TibaudoRomain/ProjetAR/Reports/Romain/Report18.md

# **Séance 18 - 09/05/2024**
## Travail réalisé :
J'ai commencé la séance par travailler sur le code des nouveaux capteurs que sont le ph-mètre et le capteur de pression.



Ensuite, j'ai travaillé sur l'emplacement des composant sur la plaque à l'intèrieur du cylindre.



Puis, j'ai imprimé plus de supports pour les ESC.



Ensuite, pour réduire la place que prendra la caméra, j'ai aidé Anas à démonté la caméra logitech. Pour ce faire, on a du détâcher puis découper un des câbles pour ensuite le ressouder au circuit imprimé.



Enfin, j'ai fais le modèle pour la découpe laser de la plaque qui supporterra l'électronique.



## Objectifs pour les prochaines scéances :
- Terminer l'assemblage du robot
- Tester le code en situation
