TibaudoRomain/ProjetAR/Reports/Anas/séance 17.md

# **Séance 17**
## *07-05-2024* 
## Travail réalisé : 

Lors de cette séance, j'ai commencé par déballer les capteurs de température, de pression et le pH que nous avions reçus. J'ai effectué quelques soudures sur le capteur de pression. Ensuite, j'ai procédé à la disposition de toute notre électronique sur la pièce en bois qui sert de support. J'ai donc pris plusieurs mesures et fait des tracés afin d'optimiser l'espace à l'intérieur de notre tube. Ensuite, j'ai percé tous les trous qui serviront à fixer les cartes, les ECS, les shields et la batterie, puis j'ai fixé l'électronique à sa place.

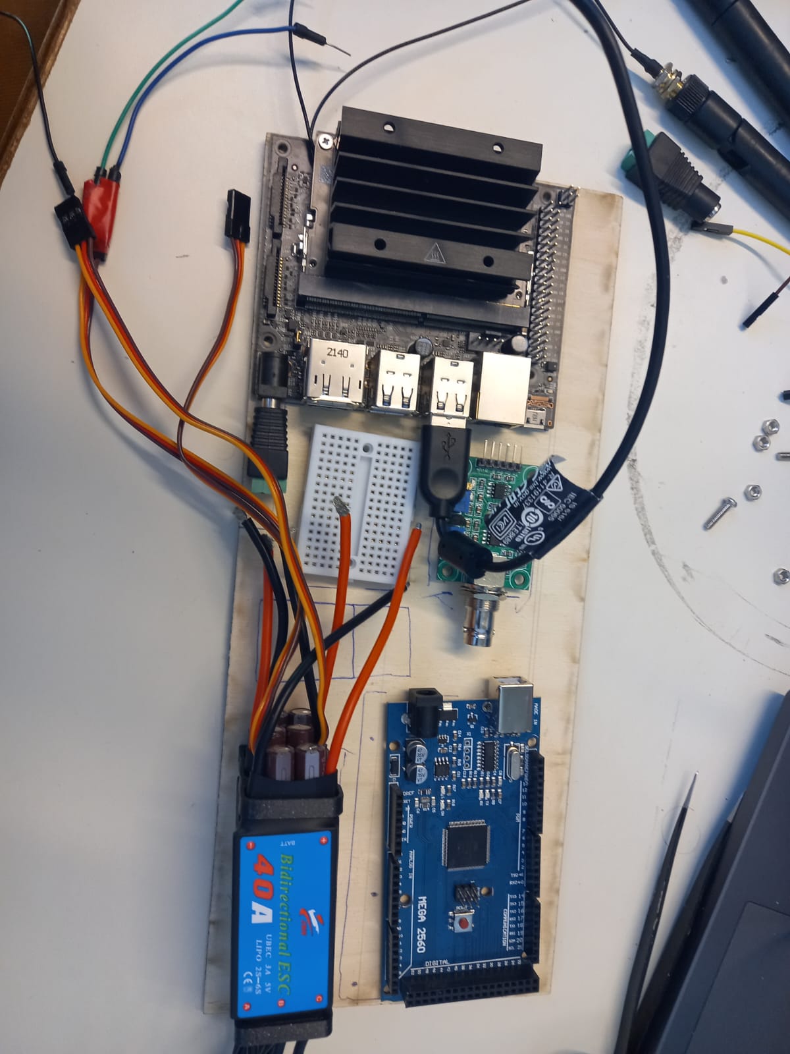
[picture p1: Reports/Anas/Images/WhatsApp Image 2024-05-08 à 16.44.29_d7d7ad65.jpg]


Ensuite, j'ai écrit un code afin de pouvoir lire les valeurs du capteur de température et du pH mètre sur la carte Jetson. J'ai trouvé une bibliothèque Python, Jetson.GPIO, qui permet de contrôler les broches GPIO de la carte Jetson. Cependant, les broches GPIO de la Jetson ne sont pas analogiques et donc ne peuvent pas traiter les données du capteur de température et du pH mètre. J'ai donc opté pour la carte Arduino pour ces capteurs-là.
