TibaudoRomain/ProjetAR/Reports/Romain/Report17.md

# **Séance 16 - 09/04/2024**
## Travail réalisé :
J'ai commencé la séance par l'assemblage du support des nouveaux moteur, pour cela j'ai vissé à la structure que j'ai préalablement percée, la plaque en plexiglass et les supports moteurs fabriqués pendant la dernière séance. Ces nouveaux supports sont bien plus solides et permettront de tenir fermement les moteurs horizontaux. Voici à quoi la structure ressemble maintenant :



Ensuite, sur les conseils de M.Peter, j'ai changé le design de la structure interne, pour créer une glissière qui permettra d'insérer les composant plus facilement tout en sauvegardant de la place. Voici les modèles 3d que j'ai modéliser pour créer cette glissière.

Les supports de la glissière :



La glissière :


Enfin, j'ai cherché un moyen de fixer les ESC au support interne, ce qui est plus compliqué que de fixer le reste des composants car il n'y a pas de points d'attache et la surface est irrégulière.



J'ai opté pour une atache par les bords des ESC, ce qui sera plus rapide que de faire un boitier. J'ai commencé par faire un prototype à la découpeuse laser qui a malheureusemant cassé.



Cependant il demeurait assez intègre pour le tester sur les ESC :



J'ai enfin modifié un peu les modèles 3d et lancé l'impression d'une partie. 



## Objectifs pour les prochaines scéances :
- Découper la plaque qui supporterra l'électronique du robot et assembler la structure interne au cylindre
