TibaudoRomain/ProjetAR/Reports/Anas/séance 15.md

# **Séance 15**
## *02-04-2024* 
## Travail réalisé : 

Lors de cette séance, j'ai rencontré plusieurs problèmes. 
Pour commencer, la carte SD de notre carte Jetson n'était plus reconnue, j'ai donc dû utiliser une autre. Pendant le temps nécessaire à l'initialisation de la carte Jetson et au téléchargement de tout le contenu, j'ai vissé les moteurs arrière au châssis, puis je les ai branchés aux ESC afin de faire une démonstration.
Je n'avais plus le temps de commencer le travail sur le modèle d'IA que nous utiliserons. Cependant, j'ai quand même cherché quel modèle pourrait nous intéresser. Ensuite, j'ai essayé d'au moins cloner le GitHub qui contient tous les modèles qui pourraient m'intéresser sur la Jetson, mais j'ai eu l'erreur suivante. 
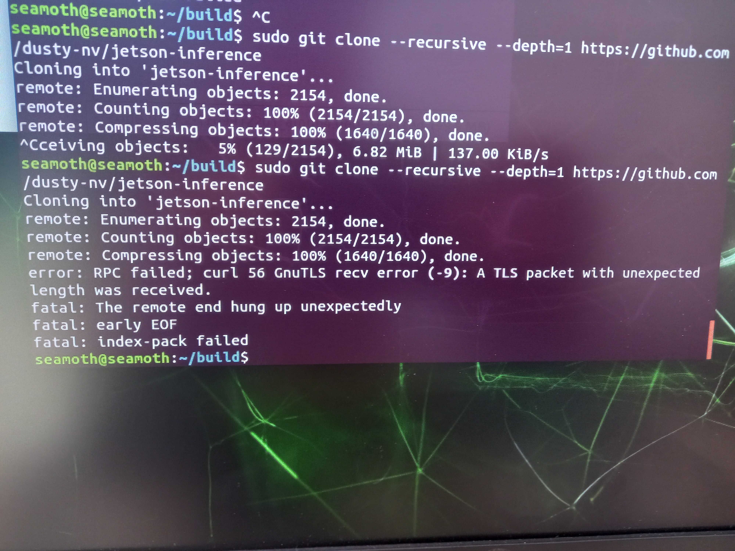
[picture p2: Reports/Anas/Images/20240402_102347.jpg]


J'ai donc passé le reste de la séance à essayer de régler ce problème.
Objectifs pour la séance prochaine : 
-       regler le probléme que j ai rencontré et avancer sur le modele d'ia
