TibaudoRomain/ProjetAR/Reports/Romain/Report16.md

# **Séance 16 - 09/04/2024**
## Travail réalisé :
J'ai commencé la séance en modifiant les modèles des supports pour les réimprimer plus rapidement.



Puis j'ai imprimé les 2 modèles.

impressionsupmot

J'ai ensuite modélisé un nouveau support plus solide pour les moteurs horizontaux et les ai imprimés.



Enfin j'ai modélisé une plaque pour attacher les supports à la structure du robot. J'ai utilisé la découpeuse laser pour créer la pièce.



## Objectifs pour les prochaines scéances :
- Créer un boitier qui permettra d'attacher les ESC et la batterie à la plaque
- Découper la plaque qui supporterra l'électronique du robot et assembler la structure interne au cylindre
