TibaudoRomain/ProjetAR/Reports/Romain/Report15.md

# **Séance 15 - 02/04/2024**
## Travail réalisé :
J'ai commencé la séance en modifiant les modèles des supports pour les rendre plus solides.



Puis j'ai imprimé la partie haute du modèle et découpé une plaque en bois pour testé l'assemblement des supports. J'ai fait cela car le temps d'impression des supports est trop long.



J'ai aussi modéliser en 3d la plaque qui servira au support des cartes, de la batterie et des ESC.



Ensuite, j'ai travaillé sur le contrôle des moteurs via bluetooth pour pouvoir présenter leur fonctionement plus facilement.

Enfin j'ai complété le programme qui servira à contrôler les moteurs avec la arduino mega.

## Objectifs pour les prochaines scéances :
- Créer un boitier qui permettra d'attacher les ESC et la batterie à la plaque
- Imprimer les supports de la plaque
- Découper la plaque et assembler la structure interne au cylindre
