TibaudoRomain/ProjetAR/Reports/Romain/Report14.md

# **Séance 14 - 19/03/2024**
## Travail réalisé :
J'ai commencé la séance en modélisant le cylindre afin de pouvoir créer plus facilement le support pour les cartes et la batterie.



Ensuite, j'ai modélisé l'attache inférieure pour le support. Cette attache va permettre au support de ne pas bouger à l'intérieur du cylindre et sera montée serrée sur le joint en bas du cylindre.




Ensuite, j'ai modélisé l'attache supérieure pour le support. Cette attache doit permettre l'ajout d'un support pour la caméra.



Cependant, pour pouvoir obtenir les mesures nécessaires afin de modéliser une attache aux bonnes dimensions, j'ai dû créer plusieurs disques avec la découpeuse laser et tester s'ils s'inséraient bien dans le joint.

J'ai enfin pu commencer à créer un programme pour contrôler les moteurs avec mon téléphone. Je n'ai besoin que de contrôler les moteurs horizontaux car les autres vont, pour l'instant, servir uniquement à la stabilisation du robot.

## Objectifs pour les prochaines scéances :
- Assembler l'électronique du robot
- Imprimer le support
- Améliorer le PID
