TibaudoRomain/ProjetAR/Reports/Anas/séance 14.md

# **Séance 14**
## *29-03-2024* 
## Travail réalisé : 

Lors de cette séance, j'ai commencé par prendre des mesures sur le tube en plexiglas afin que mon collègue puisse le modéliser sur Fusion 360.

Ensuite, je me suis mis à fixer les pièces imprimées lors de la dernière séance à notre base en bois. J'ai pris les mesures nécessaires, puis j'ai effectué les marquages pour les vis avant de les visser.
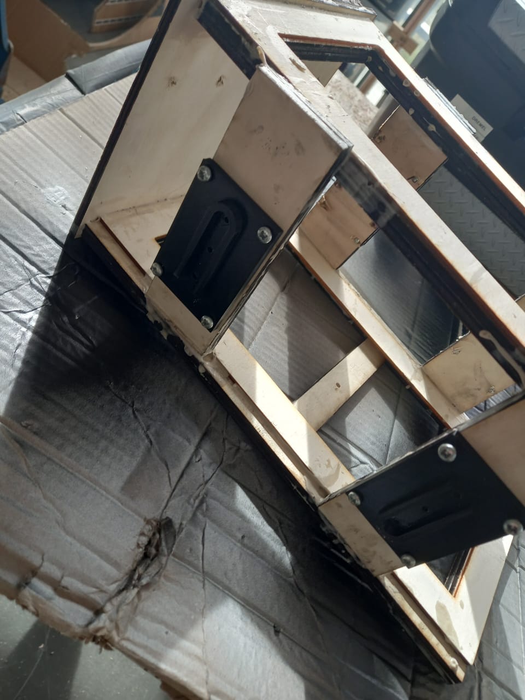
[picture p3: Reports/Anas/Images/WhatsApp Image 2024-03-30 à 11.53.24_18565550.jpg]


Ensuite, j'ai attaché les moteurs à la structure.

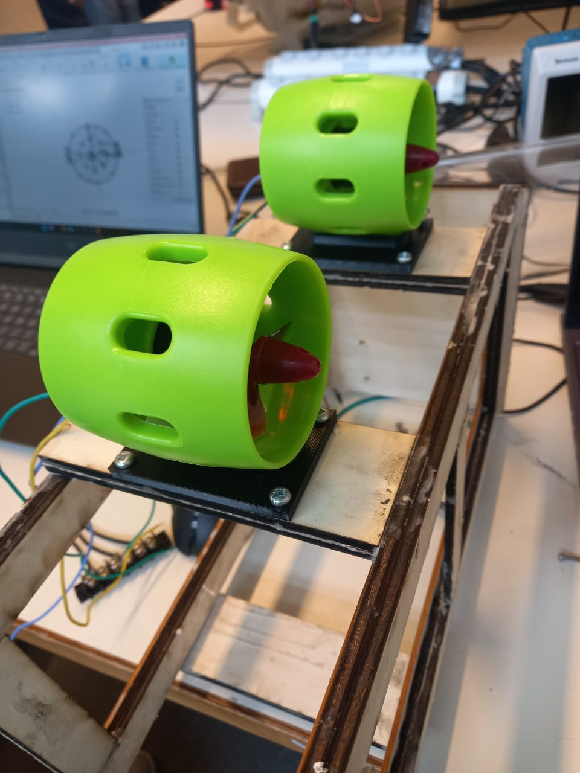
[picture p4: Reports/Anas/Images/WhatsApp Image 2024-03-30 à 11.53.24_260b4752.jpg]


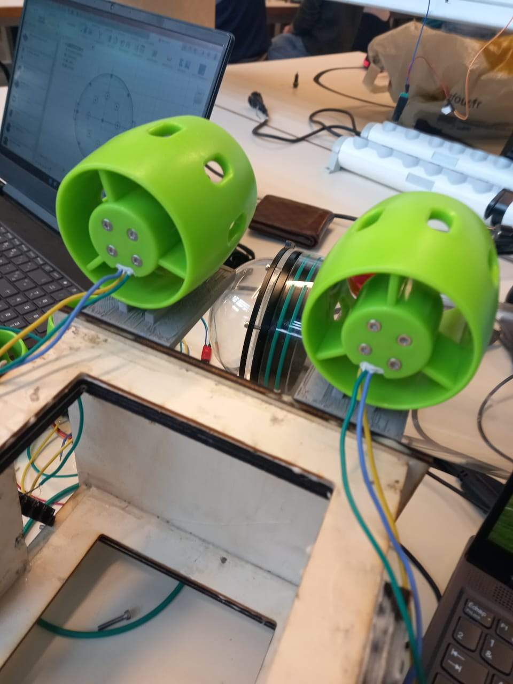
[picture p5: Reports/Anas/Images/WhatsApp Image 2024-03-30 à 11.53.24_44018f7d.jpg]


Enfin, je me suis mis à la recherche d'un modèle d'IA qui nous permettrait de naviguer sous l'eau à l'aide de notre caméra. J'ai trouvé plusieurs modèles de NVIDIA très intéressants pour notre projet.



Objectifs pour la séance prochaine : 
- Essayer les modèles trouvés sur la Jetson Nano afin de déterminer leur utilité pour notre projet.
