TibaudoRomain/ProjetAR/Reports/Romain/Report12.md

# **Séance 11 - 06/03/2024**
## Travail réalisé :
J'ai commencé la séance en imprimant en 3d des pièces manquantes pour la structure du robot. 



Ensuite, j'ai testé le sonnar sous l'eau en remplissant une boite d'eau.



Cependant malgrés le fait que la distance soit supèrieur à 20cm les mesures étaient inconssistantes, en effet peu importe à quel point j'écartais le sonnar de l'obstacle la distance restait à environ 80cm. J'ai ensuite regardé la datasheet qui m'a indiqué que le sonnar est prévu pour fonctionner sur une portée de 20 à 600cm. 



Or le son se déplace 4 fois plus vite dans l'eau que dans l'air donc une distance de 80cm serait logique.
J'ai ensuite essayé de tester le capteur pour une distance plus longue. 



Cependant du à l'angle de mesure de 75° le bassin utilisé était trop fin ce qui m'a empéché de faire des mesures. J'ai ensuite retenté en modifiant le programme ce qui m'a rendu la même chose. Ensuite j'ai aidé mon coéquipier à assembler une partie de la structure.

## Objectifs pour les prochaines scéances :
- Régler le problème de mesure à courtes distances du sonnar
- Faire un programme permettant au robot de se déplacer
- Programmer l'évitement d'obstacles
