TibaudoRomain/ProjetAR/Reports/Romain/Report11.md

# **Séance 11 - 06/03/2024**
## Travail réalisé :
J'ai commencé la séance en travaillant sur le sonar. Celui-ci me donnant des valeurs pas stables et peu précises, ce qui peut empiéter sur le déplacement du robot et lui faire détecter des obstacles qui n'existent pas. Le premier problème que j'ai voulu régler est la stabilité de la mesure en effet quand j'essaie de faire des mesures avec le sonar je me retrouve avec des suites de valeurs contenant des valeurs isolées qui différencient fortement du reste.



Pour régler ce problème, j'ai décidé de prendre plus de mesures (avec une fréquence plus grande) de les séparer en groupe de 11 mesures puis de renvoyer la médiane de ces mesures. Pour ce faire, j'ai choisi d'ajouter les 11 premières valeurs dans une liste à 11 éléments puis d'ordonner la liste en utilisant un tri par insertion et de renvoyer le 6e élément de la liste, de même pour les 11 prochaines valeurs et ainsi de suite. Cependant, après avoir recherché comment le tri fonctionnait, je n'ai pas réussi à l'implémenter, la liste initialisée comme une liste de 11 zéros n'acceptait pas les valeurs par lesquels j'essaiyais de changer les zéros.

Cependant, pour ne pas perdre de temps, je me suis mis à régler l'autre problème du sonar, les distances qu'il renvoie ne sont pas assez précise, à une distance de 1m le sonar renvoyait une distance de 93.5 cm. 



J'ai donc mesuré la différence de distance entre la réalité et ce que mon programme renvoyait pour pouvoir trouvé un facteur par lequel je peux multiplier la valeur du sonar pour avoir des mesures plus précises.





J'ai aussi pu remarquer un autre problème, pour des distances en dessous de 28 cm le sonar ne me renvoie que des valeurs autour de 25 cm, même si la distance est de 5 cm.

## Objectifs pour les prochaines scéances :
- Régler le problème de mesure à courtes distances du sonnar
- Faire un programme permettant au robot de se déplacer
- Programmer l'évitement d'obstacles
