TibaudoRomain/ProjetAR/Reports/Anas/séance 6.md

# **Séance 6**
## *16-01-2024* 

## Travail réalisé :

Lors de cette séance de projet, j ai finalisé la modelisation de notre coque exterieur.
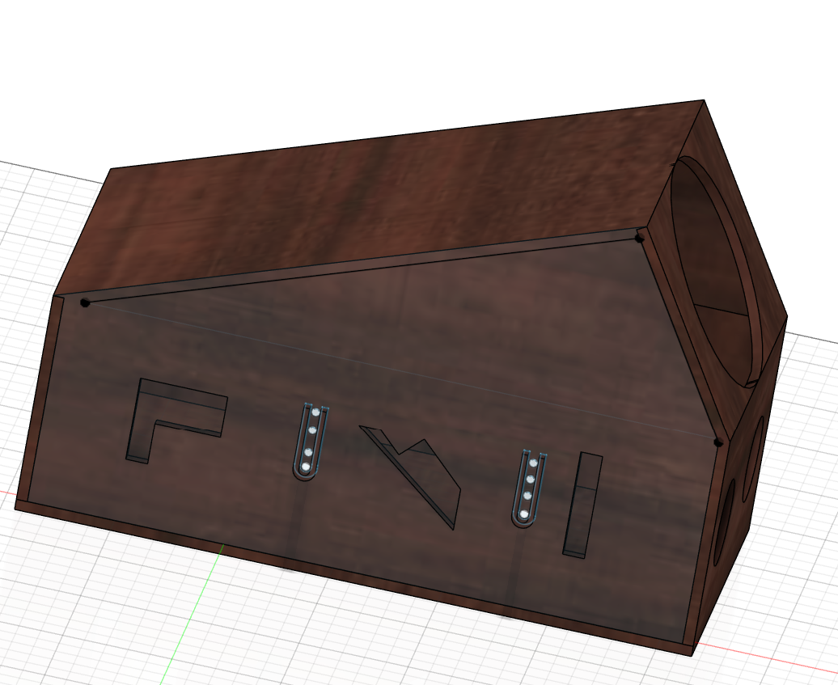
[picture p6: Reports/Anas/Images/coque V3.png]

Maintenant que la conception est terminée, je me suis lancé dans l'impression de toutes les pièces de fixation que j'avais modifiées. Lors de l'impression du attache-tube, j'ai rencontré un problème de conception. J'ai donc changé ma façon de voir les choses et ai décidé de simplement tarauder la pièce de fixation après l'avoir imprimée.
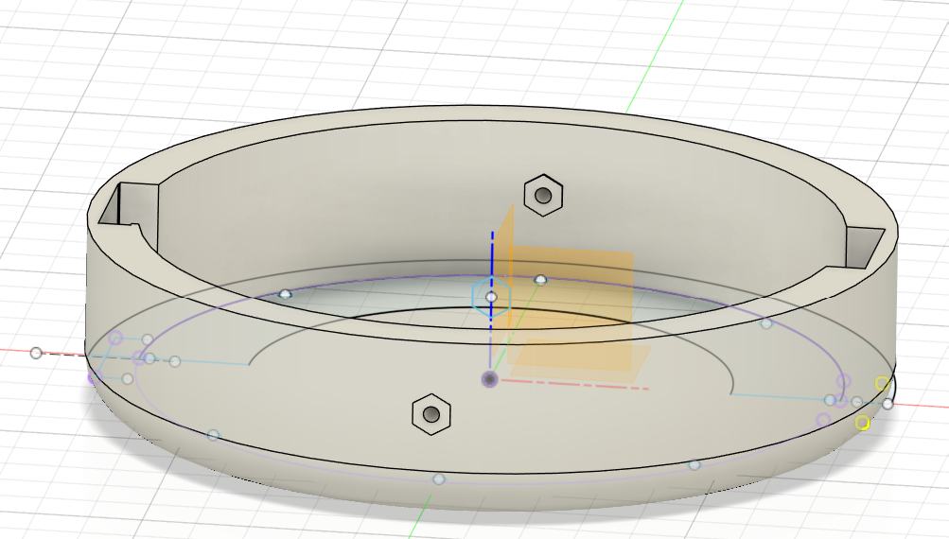
[picture p7: Reports/Anas/Images/attache tube.png]

Ensuite, j'ai réfléchi à une manière de partitionner notre tube afin de pouvoir fixer nos composants électroniques de manière efficace, sans encombrement. J'ai donc modélisé une pièce qui servira à organiser l'intérieur de notre tube
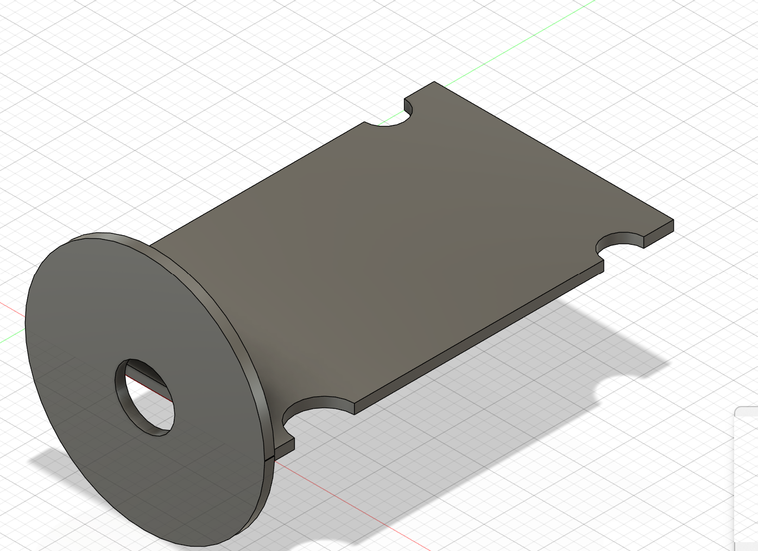
[picture p8: Reports/Anas/Images/fixation electronique.png]


Objectif de la séance prochaine : 
-	Modéliser une solution de fixation pour les deux moteurs à l'arrière de la boîte, puis construire notre robot.
