TibaudoRomain/ProjetAR/Reports/Anas/séance 5.md

# **Séance 3**
## *08-12-2023* 

## Travail réalisé :
Lors de cette séance de projet, j'ai concentré mes efforts sur la sélection d'un modèle de coque pour notre projet. Après une analyse minutieuse, j'ai fait le choix d'un modèle qui répond le mieux à nos critères .j'ai aussi opté pour le bois comme matériau pour la coque, vu la simplicité de travailler avec du bois, et surtout parce que nos critères d'étanchéité ne concernent pas cette pièce-là.
Ensuite, j'ai entamé la modélisation 3D de cette coque ,en prenant en compte les spécifications et les détails techniques nécessaires. Loin d'une simple enveloppe pour notre projet, j'ai choisi un modèle qui incarne l'innovation et la créativité, un modèle géométrique simpliste mais efficace.
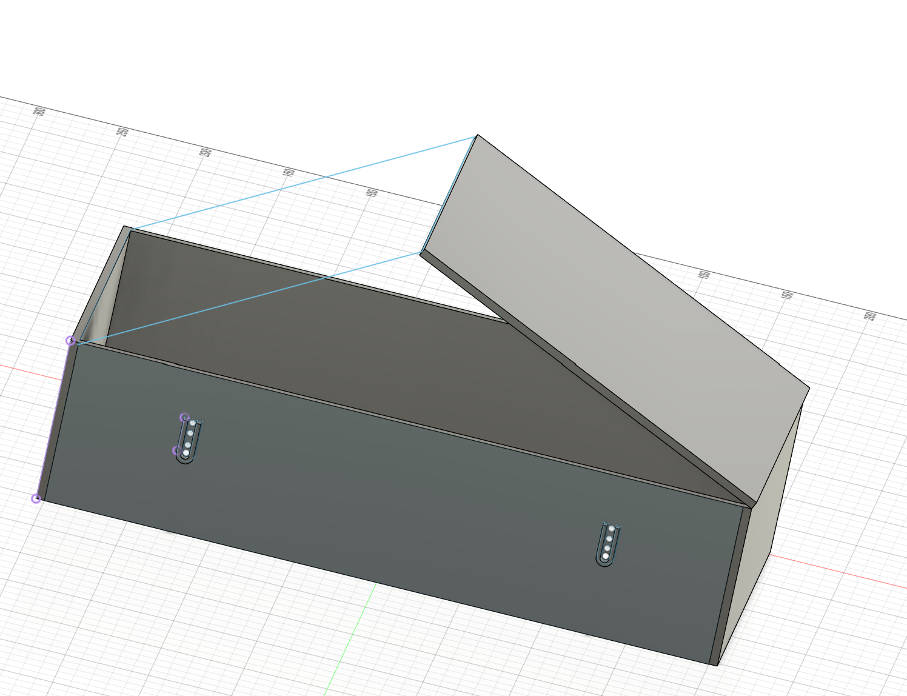
[picture p9: Reports/Anas/Images/coque V1.png]

J'ai également modélisé une pièce permettant de fixer les moteurs aux faces de la coque, lesquels seront ensuite vissés. Cependant, en raison d'une erreur concernant le tube commandé, j'ai dû revoir toutes les solutions de fixation pour le tube. Désormais, je prévois d'intégrer une fixation directement dans la coque ainsi qu'une trappe à l'arrière de celle-ci, permettant un accès au tube sans démontage. Cette trappe sera percée pour faciliter le passage des fils nécessaires de l'intérieur du tube vers l'extérieur, en utilisant la méthode que Xavier nous a montrée lors de la dernière séance.

Objectif de la séance prochaine : 
-	construire la coque et imprimer toutes les pièces de fixation avant de passer au montage final.
