TibaudoRomain/ProjetAR/Reports/Romain/Report04.md

# **Séance 4 - 12/12/2023**
## Travail réalisé :
Après avoir écrit l'image de la jetson nano sur la carte SD, je me suis penché sur la centrale inertielle MPU 6050 :


J'ai commencé par faire les branchements et souder connecteurs à la centrale inertielle.



Ensuite j'ai testé le programme exemple de l'IDE pour la MPU 6050 nommé MPU6050DMP6 en ayant installé au préalable les librairies MPU6050 et I2Cdev. Cependant le programme me renvoi le message d'erreur suivant :



N'ayant pas trouvé la solution, j'ai testé d'autres programme dont celui ci-dessous qui m'a renvoyer trois angles nuls qui ne changeaient pas peu importe comment je déplaçais la centrale inertielle.



## Objectifs pour la semaine prochaine :
Pour la prochaine scéance, l'objectif sera de faire marcher une centrale inertielle et de commencé à coder des communications entre l'arduino et la jetson.
