TibaudoRomain/ProjetAR/Reports/Anas/séance 2.md

# **Séance 2**
## *21-11-2023* 
## Travail réalisé :
Pendant cette séance, je me suis intéressé aux différentes solutions possibles pour rendre étanche la boîte où  notre partie électrique sera stocké. L'impression 3D est une solution réalisable, mais cela pose plusieurs défis qui sont certes surmontables. Cependant, nous recherchons ici la simplicité. 
Ainsi, un tube en plexiglas représente la solution optimale. Ce tube d'un diamètre de 110 mm et d'une hauteur de 30 cm, avec deux bouchons à joint fixés par des vis. Cette solution nous permet d'assurer une étanchéité optimale tout en nous permettant d'intervenir à l'intérieur de la boîte sans causer de fuites.


En ce qui concerne les câbles, nous prévoyons de les relier tous ensemble et de les envelopper dans un tube flexible pour les joindre à l'un des couvercles de notre boîte. J'ai donc recherché le matériel dont nous avons besoin afin de passer commande le plus rapidement possible. Ensuite, j'ai modélisé une solution pour fixer notre tube à la coque de notre robot extérieur.



Ces fixations serviront à bloquer le tube dans la coque afin de ne pas endommager tout ce qui se trouve à l'intérieur du tube.

La modélisation de toutes les pièces de fixation est presque terminée. Il ne me reste plus qu'à attendre de recevoir le tube afin de prendre les mesures de dernière minute et d'imprimer toutes les fixations.

Objectifs pour la séance prochaine : 
-       imprimer les fixations
-       avancer sur le modele de la coque exterieur
