TibaudoRomain/ProjetAR/Présentation/PresentationSeamoth.pdf

# Projet Seamoth

Par Malhouq Anas et Tibaudo Romain

# Présentation du projet

Objectifs :
- Se déplacer sous l’eau de manière autonome
- Analyser son environnement

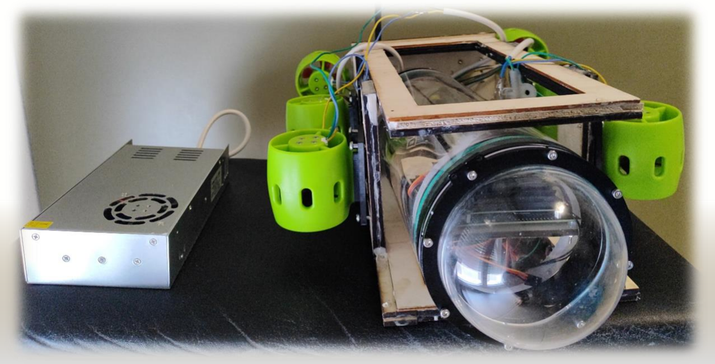
[picture p17: figure]

# Fonctionnement général

- Synoptique

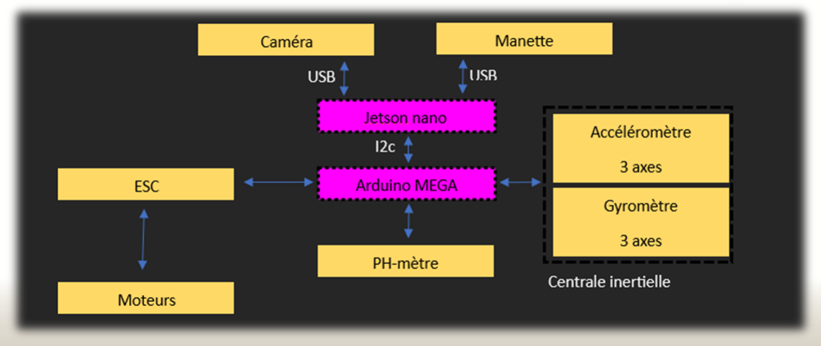
[picture p18: figure]

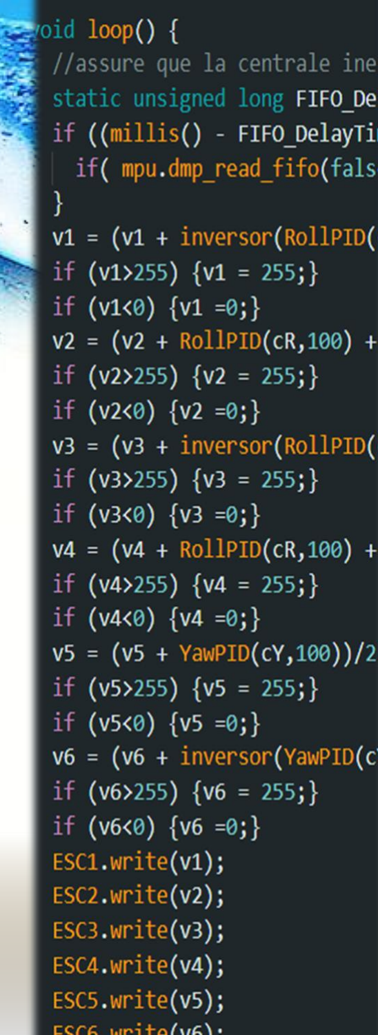
[picture p19: figure]

# Fonctionnement du code

- Une Arduino MEGA pour le déplacement
- Une Centrale inertielle
- Un PID pour la stabilisation
- 6 ESC pour contrôler les moteurs
- Une Jetson Nano pour analyser son environnement
- Une caméra
- Un modèle d’IA pour faire un recensement des espèces
- Une manette pour contrôler la direction des moteurs
- Un code master sur la Jetson pour lire les inputs de la manette.
- Un code slave sur l’Arduino pour recevoir les données via i2c

# L’architecture du robot

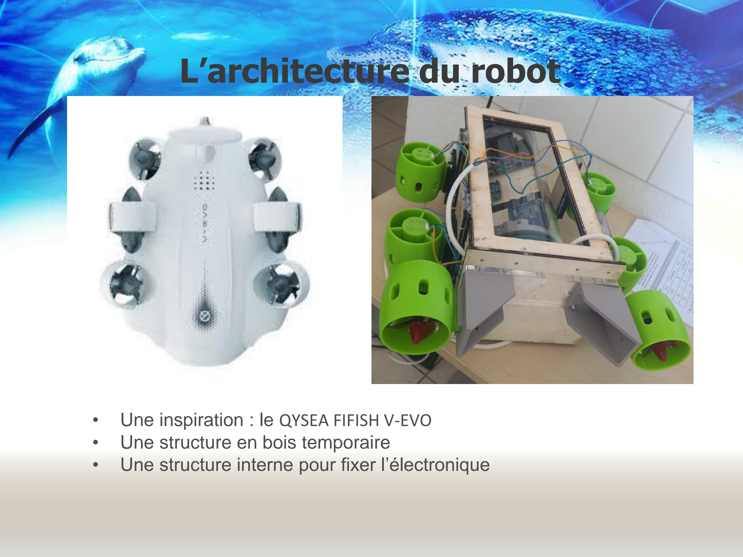
[picture p20: page 5]

- Une inspiration : le QYSEA FIFISH V-EVO
- Une structure en bois temporaire
- Une structure interne pour fixer l’électronique

# Jetson nano

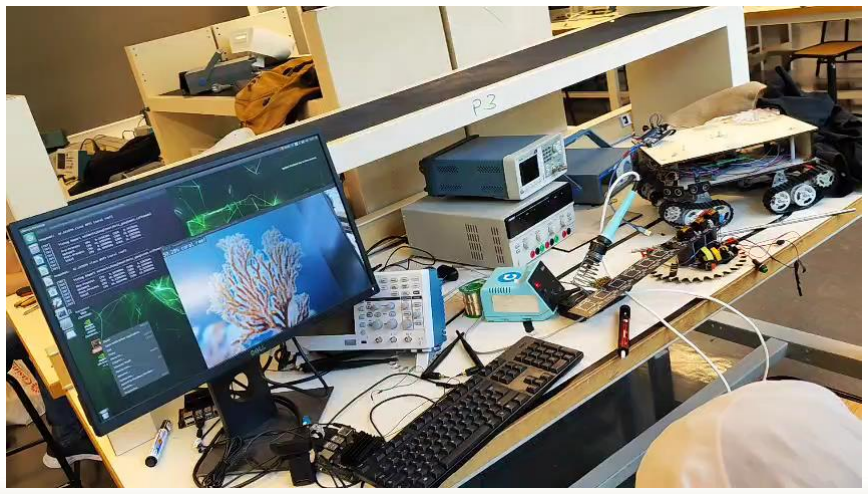
[picture p21: figure]

# Jetson nano

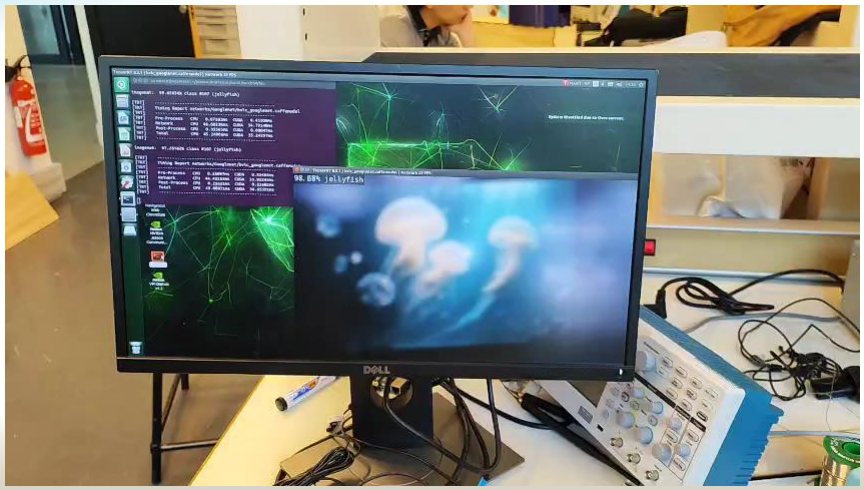
[picture p22: figure]

# Problèmes rencontrés

## Problèmes de code Problèmes d’électronique Problèmes de structure

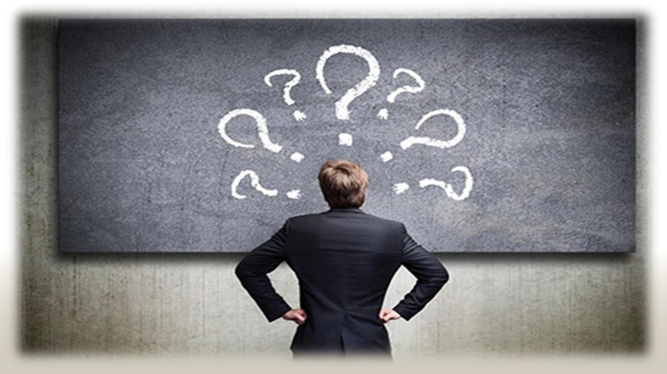
[picture p23: figure]

# Les futures améliorations
