TibaudoRomain/ProjetAR/Reports/Anas/séance 16.md

# **Séance 16**
## *09-04-2024* 
## Travail réalisé : 

Après quelques heures de recherche, j'ai trouvé une personne sur GitHub qui avait rencontré le même problème que moi. J'ai donc suivi ce qu'il avait fait et j'ai enfin réussi à cloner le GitHub de l'IA.

Pendant que le GitHub se clonait et que le docker se téléchargeait, j'ai lu la documentation du GitHub afin de trouver le modèle qui m'intéresserait ainsi que la méthode pour l'entraîner. J'ai trouvé un bon modèle de classification d'image préentraîné. Ce modèle était déjà très bien entraîné, mais notre objectif étant la reconnaissance de poissons, et bien que le modèle reconnaisse déjà pas mal d'espèces de poissons, je me suis mis à la recherche d'un dataset d'espèces de poisson afin de l'entraîner davantage.

J'ai fini par regrouper une base de données assez importante, mais je n'avais plus le temps de l'entraîner. J'ai donc fait des essais afin de tester les connaissances de l'IA :

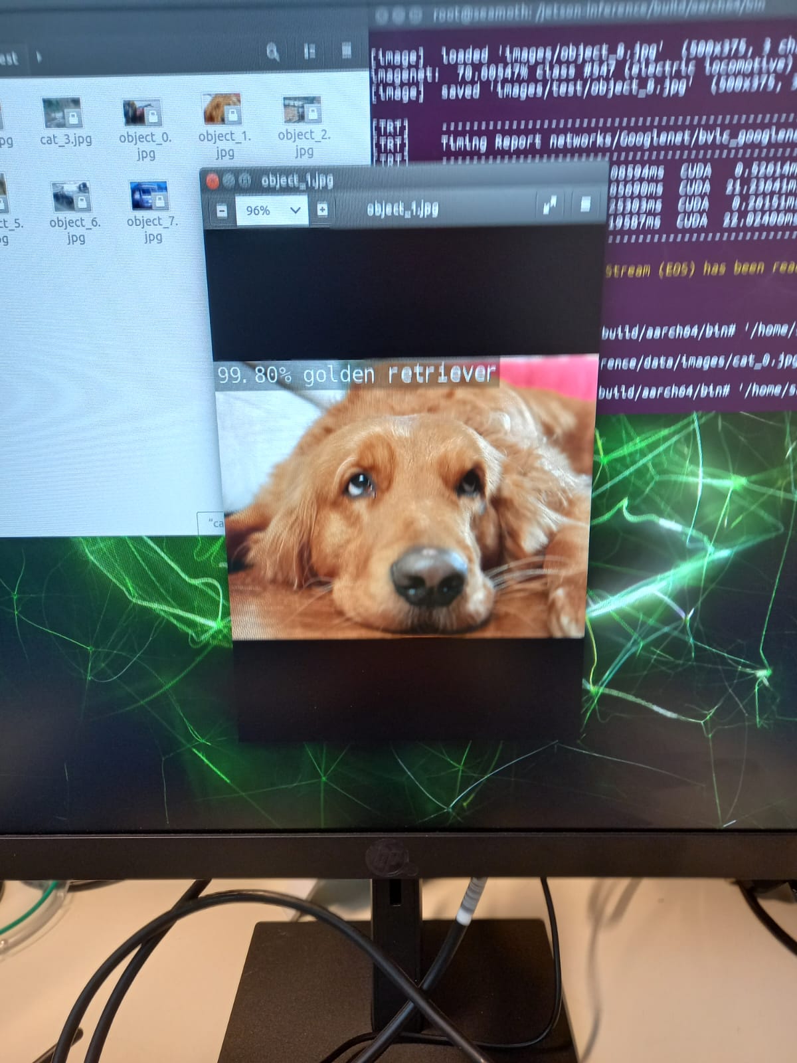
[picture p24: Reports/Anas/Images/WhatsApp Image 2024-04-10 à 18.04.29_8a8d4e60.jpg]


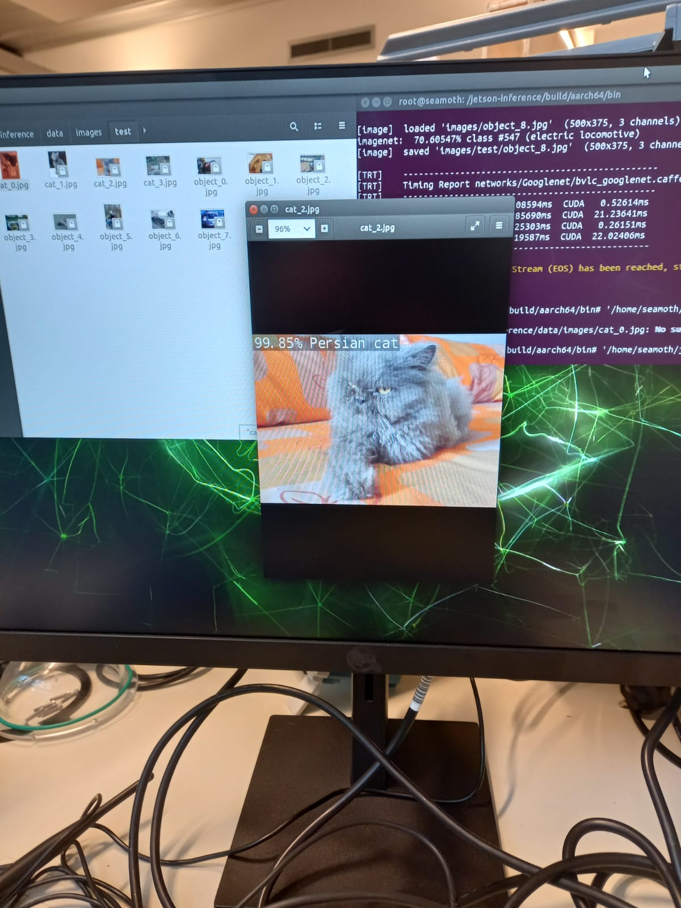
[picture p25: Reports/Anas/Images/WhatsApp Image 2024-04-10 à 18.04.37_27689edd.jpg]


J'ai également essayé de tester ce modèle sur des vidéos. Le modèle prend en charge des fichiers d'entrée au format MKV ou MP4 :
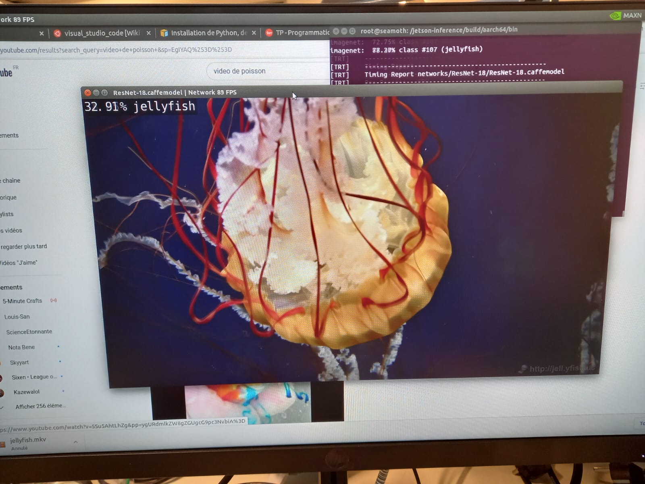
[picture p26: Reports/Anas/Images/WhatsApp Image 2024-04-10 à 18.04.16_74ce5d53.jpg]
