TibaudoRomain/ProjetAR/Reports/Romain/Report13.md

# **Séance 13 - 20/03/2024**
## Travail réalisé :
J'ai commencé la séance en imprimant en 3d des supports pour les moteurs qui manquait pour finir la structure externe du robot (externe au cylindre waterproof). 



Voici la structure du robot une fois assemblée, il manque encore une partie des supports qui étaient encore en cours d'impression.



Ensuite, après avoir décidé de changer de sonnar, je me suis mis à chercher les capteurs qui nous manquaient, notament un PH-mètre et un capteur de pression. Voici ce que j'ai trouvé : 



Ensuite j'ai rassemblé mes programmes pour qu'ils puissent interragir entre eux. Pour l'instant le code n'est tourné que par l'arduino mega.

Enfin, j'ai commencé à créer le modèle 3d du support pour l'électronique à l'intérieur du cylindre waterproof.



## Objectifs pour les prochaines scéances :
- Imprimer le support
- Paufiner le PID
