TibaudoRomain/ProjetAR/Reports/Anas/séance 13.md

# **Séance 13**
## *19-03-2024* 
## Travail réalisé : 
Pour cette séance, j'ai commencé par fixer les pièces imprimées de la séance précédente sur notre structure en bois.

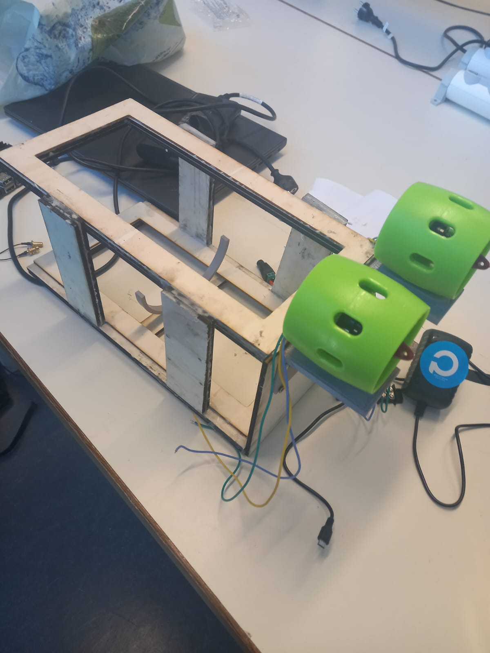
[picture p27: Reports/Anas/Images/WhatsApp Image 2024-03-20 at 15.42.54.jpeg]

J'ai ensuite modélisé les fixations des moteurs qui seront fixées sur les plaques latérales, et je les ai lancées en impression.
Ensuite, j'ai connecté la carte Jetson Nano à un moniteur, branché la caméra, et initialisé celle-ci. Enfin, j'ai testé la caméra à l'aide d'un code Python.
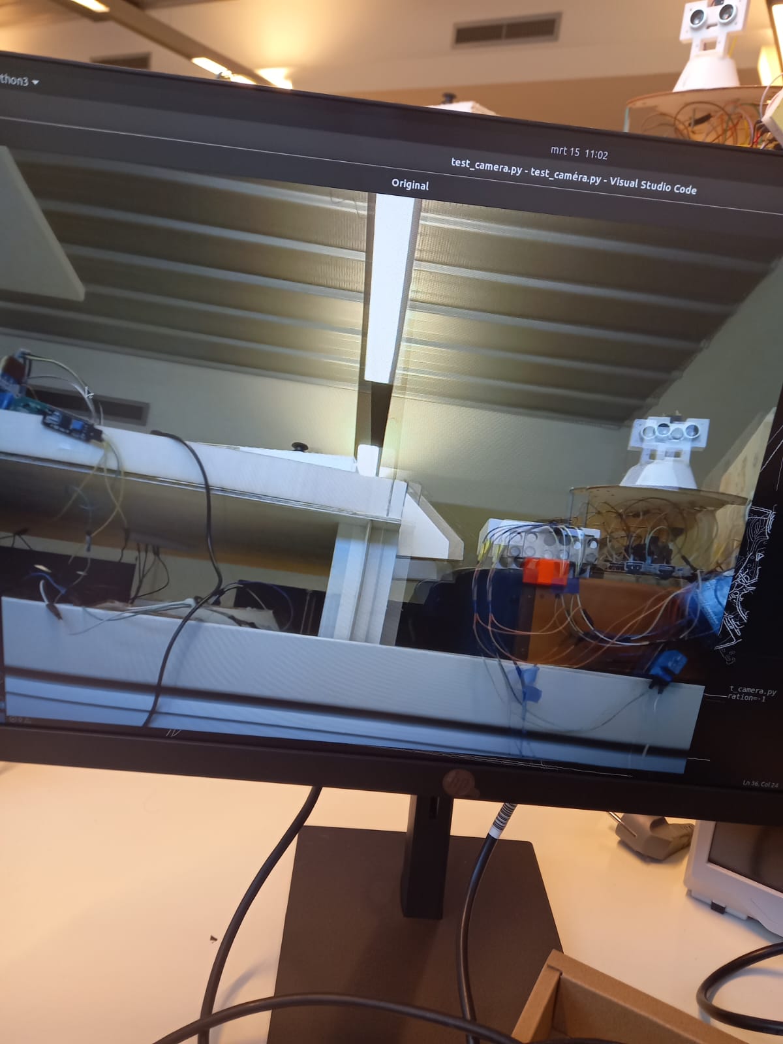
[picture p28: Reports/Anas/Images/WhatsApp Image 2024-03-20 at 15.42.55 (1).jpeg]


Ensuite, j'ai écrit un code Python qui permet de détecter les contours des objets sur la vidéo fournie par la caméra, ce qui nous donne ceci :

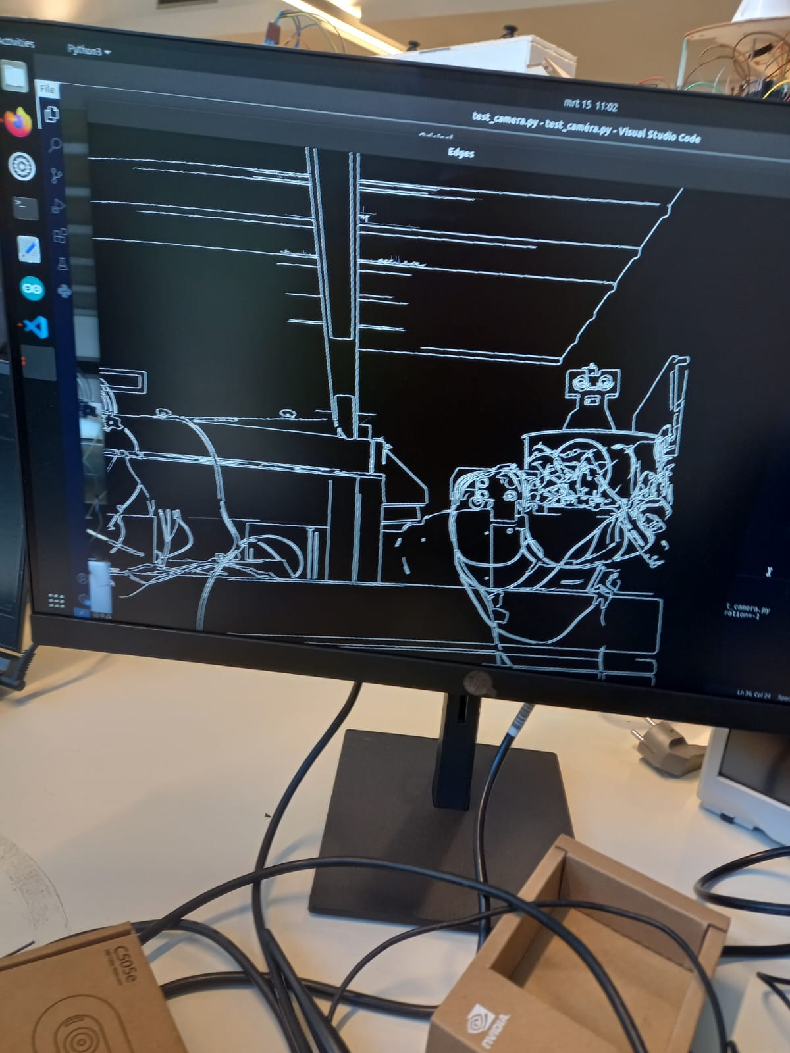
[picture p29: Reports/Anas/Images/WhatsApp Image 2024-03-20 at 15.42.55.jpeg]


Je travaille sur l'optimisation de ce code afin de pouvoir détecter les obstacles sous l'eau et ainsi nous guider.

Dans la même optique d'aider à éviter les obstacles sous l'eau, j'ai également essayé un code qui permet de changer les couleurs de la vidéo. En effet, sous l'eau, tout est bleu. Donc, si nous parvenons à détecter toute autre couleur que le bleu, nous pourrions supposer que c'est un obstacle. Cependant, cela reste peu avancé et je devrais l'essayer sous l'eau afin de l'améliorer.
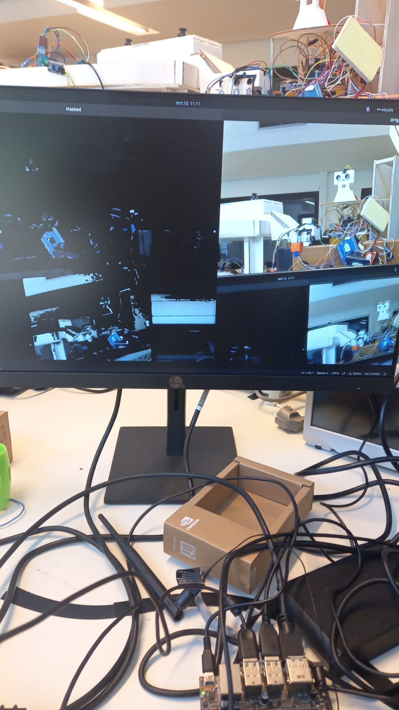
[picture p30: Reports/Anas/Images/WhatsApp Image 2024-03-20 at 15.42.55 (2).jpeg]


Comme c'était presque la fin de la séance et que je n'avais pas de moniteur chez moi pour la carte Jetson, j'ai cherché un moyen de la piloter à distance à l'aide de mon PC. Donc, avec l'aide du VNC Viewer, j'ai créé un bureau à distance de ma carte Jetson sur mon ordinateur.

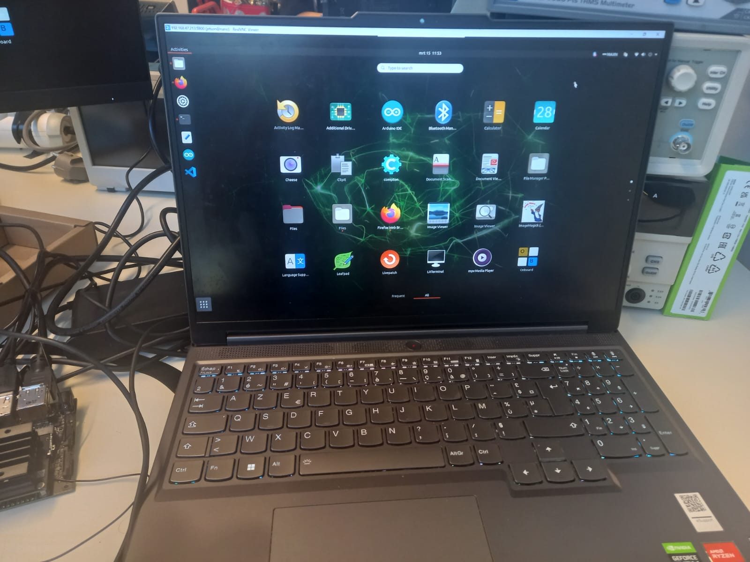
[picture p31: Reports/Anas/Images/WhatsApp Image 2024-03-20 at 15.42.55 (3).jpeg]
