TibaudoRomain/ProjetAR/Reports/Anas/séance 12.md

# **Séance 12**
## *12-3-2024* 

## Travail réalisé :
Pendant cette séance, j'ai relancé l'impression des fixations pour moteur qui n'avait pas abouti. Pendant que les impressions se terminaient, je me suis mis à monter la structure du robot. J'ai donc découpé toutes les pièces de bois à l'aide de la découpeuse laser et collé le tout avec de la colle à bois afin d'avoir une structure solide.

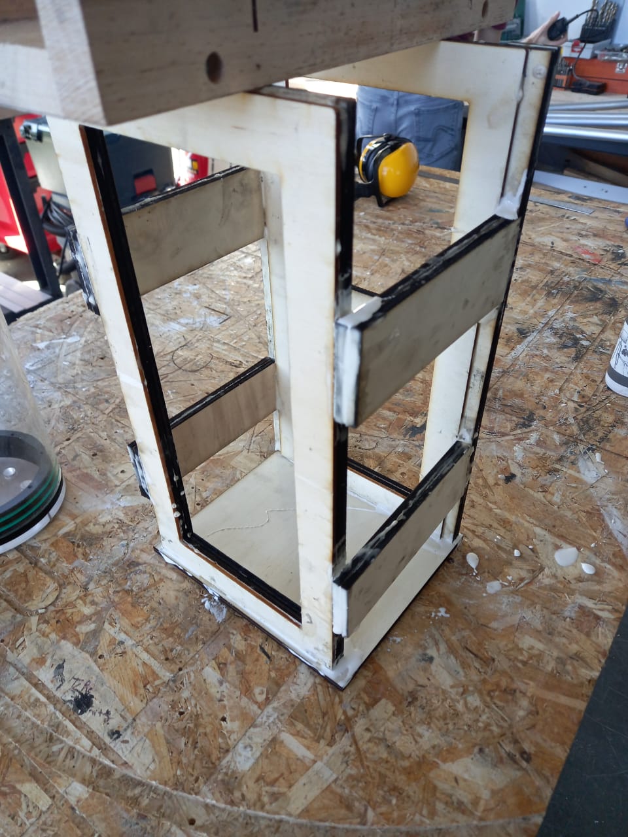
[picture p32: Reports/Anas/Images/WhatsApp Image 2024-03-19 at 07.57.59 (1).jpeg]


Une fois la colle séchée, j'ai pris les mesures nécessaires afin de découper la mèche que nous allons mettre à l'intérieur.

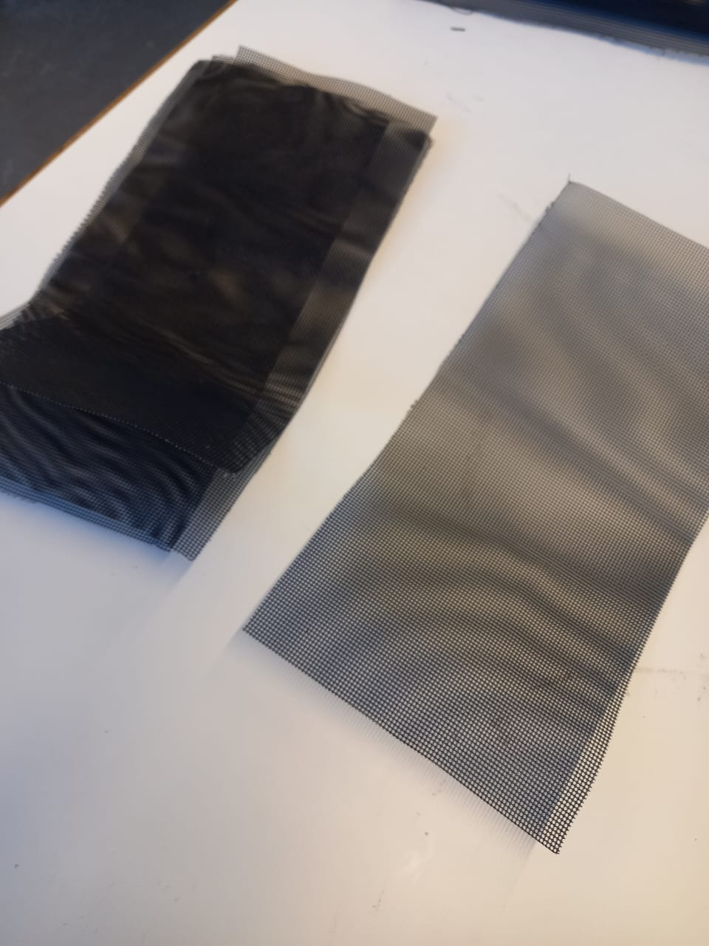
[picture p33: Reports/Anas/Images/WhatsApp Image 2024-03-19 at 07.57.59 (2).jpeg]


J'ai ensuite vérifié que notre tube rentre bien dans la structure.

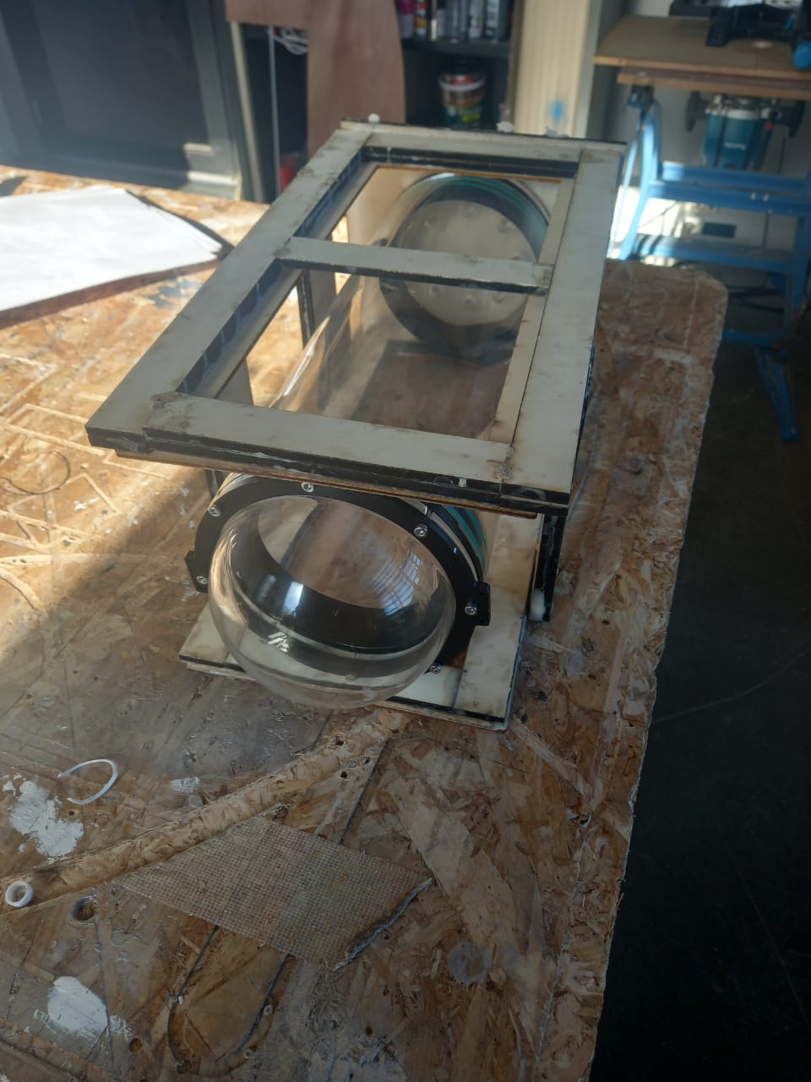
[picture p34: Reports/Anas/Images/WhatsApp Image 2024-03-19 at 07.57.59.jpeg]


Et enfin, j'ai récupéré les pièces imprimées et enlevé tous les supports.

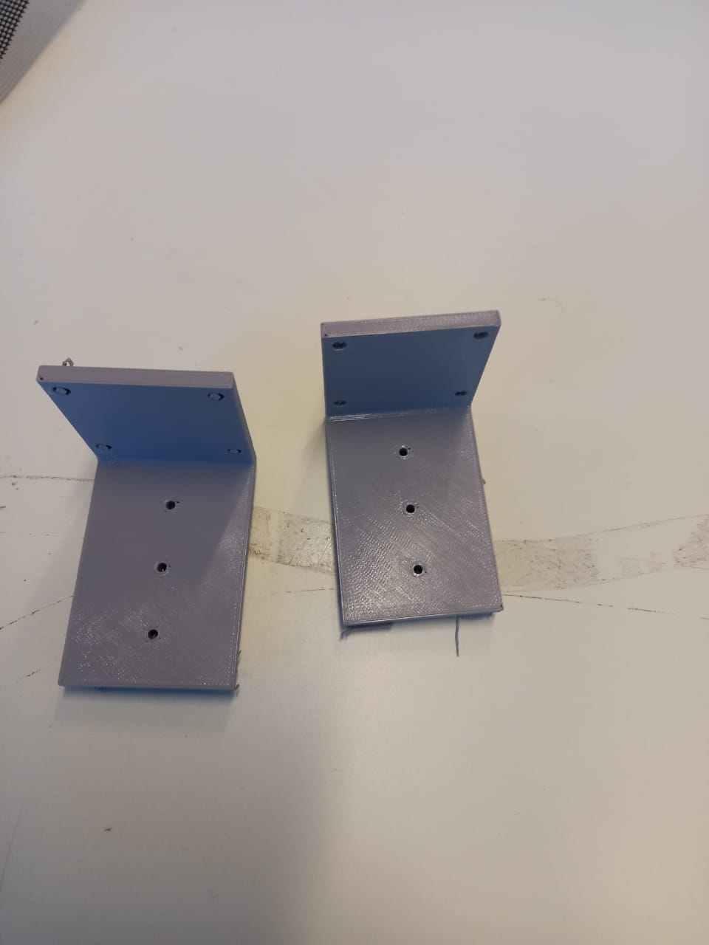
[picture p35: Reports/Anas/Images/WhatsApp Image 2024-03-19 at 07.57.59 (3).jpeg]


Objectifs pour la séance prochaine : 
- fixer les piéces imprimer sur la strucuture.
-
