TibaudoRomain/ProjetAR/Reports/Anas/séance 11.md

# **Séance 11**
## *5-3-2024* 

## Travail réalisé :*

Pour cette séance, je comptais monter la base en bois ainsi qu'imprimer les pièces de fixation des moteurs. Néanmoins, lors du montage de la base en bois, la structure a lâché. En essayant de les agencer afin de coller les pièces, une des poutres en bois s'est cassée en deux, une autre a été arrachée.
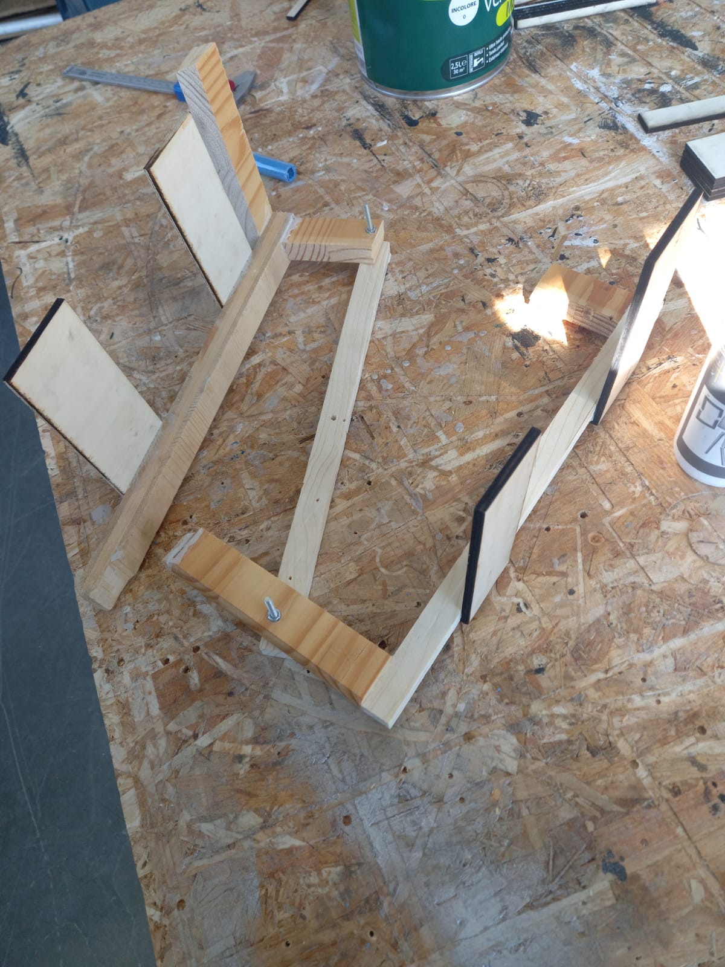
[picture p36: Reports/Anas/Images/WhatsApp Image 2024-03-07 at 19.45.27.jpeg]


À cause du manque de temps, on s'est plutôt rabattu sur la découpe laser de contreplaqué de 5 mm. J'en ai fait deux couches afin de garantir la solidité de notre robot. Après avoir découpé toutes les pièces en bois, je les avais collées et laissées sécher.

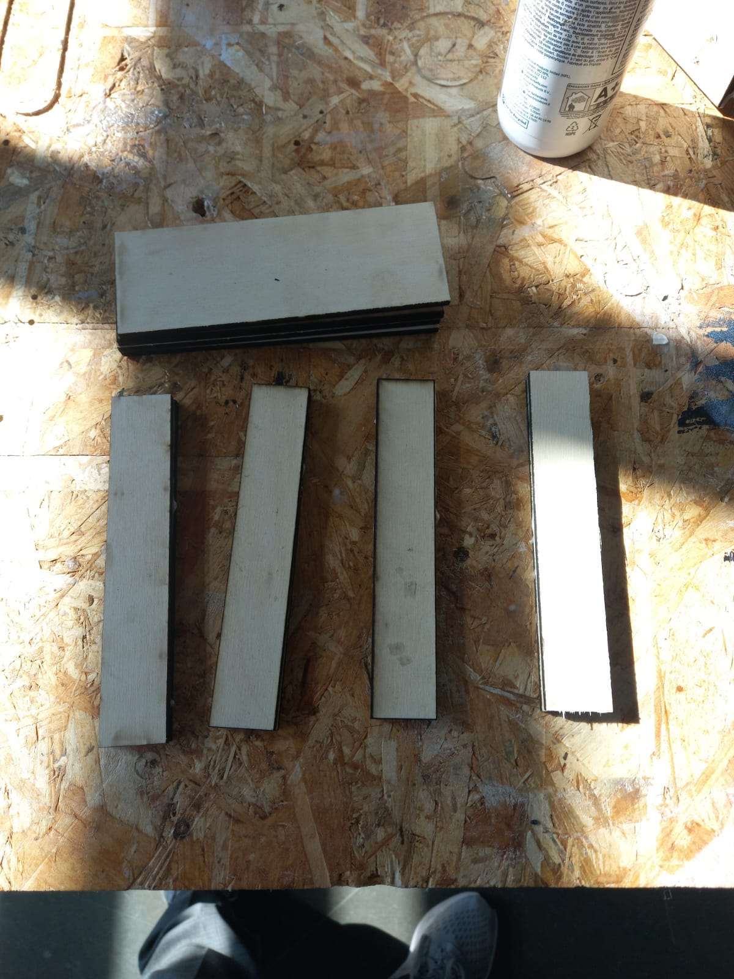
[picture p37: Reports/Anas/Images/WhatsApp Image 2024-03-07 at 19.45.26 (1).jpeg]


J'ai ensuite lancé l'impression de toutes les pièces de fixation dont j'avais besoin. Malheureusement, l'imprimante a raté l'impression à mi-chemin. Vu que c'était une impression de 3h30, je n'avais plus le temps de la relancer.
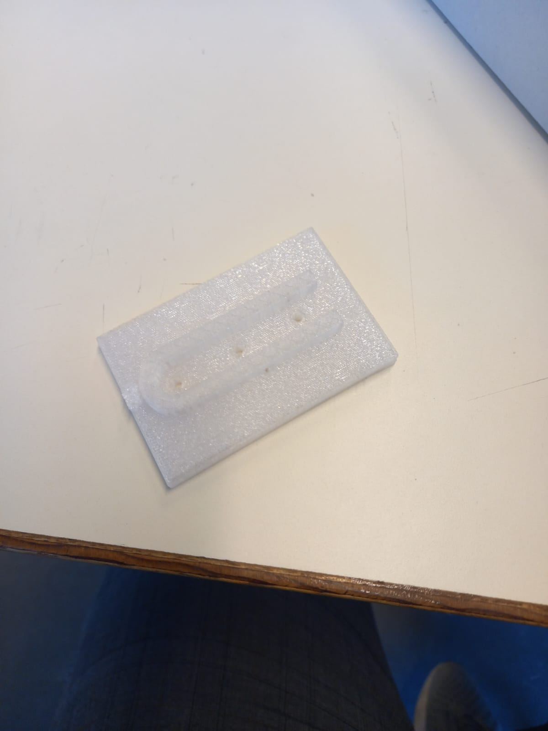
[picture p38: Reports/Anas/Images/WhatsApp Image 2024-03-07 at 19.45.28.jpeg]


Néanmoins, j'ai vérifié que les mesures étaient exactes et j'ai fixé la pièce imprimée au moteur à l'aide de vis afin de vérifier que ça fonctionne.
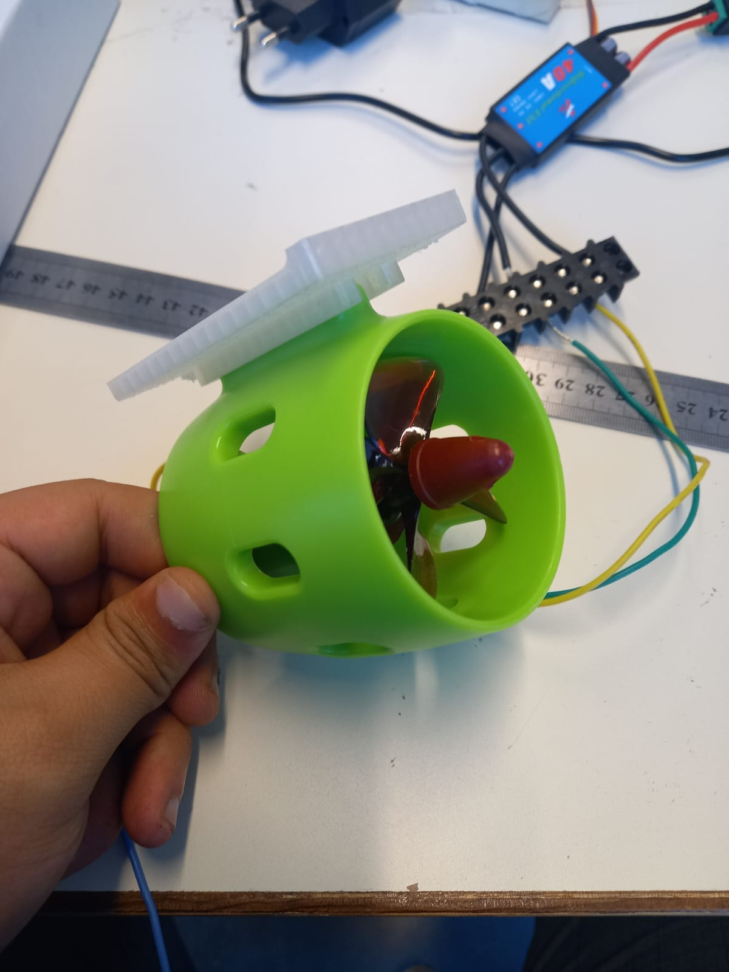
[picture p39: Reports/Anas/Images/WhatsApp Image 2024-03-07 at 19.45.28 (1).jpeg]


Objectifs pour la séance prochaine : 
-	Impression des pièces de fixation et montage du robot.
