TibaudoRomain/ProjetAR/Reports/Anas/séance 10.md

# **Séance 10**
## *21-2-2024* 

## Travail réalisé :

Après avoir reçu notre commande de mesh, il ne nous reste plus qu'à former la coque extérieure du robot, la renforcer avec des vis et effectuer des tests dans l'eau afin d'optimiser sa forme.
J'ai donc essayé de réfléchir aux pièces qu'il me reste à modéliser pour le robot, sachant que les moteurs des côtés seront directement vissés aux poutres en bois. 
Il ne me restait plus qu'à modéliser un support pour fixer les moteurs à l'arrière du robot.
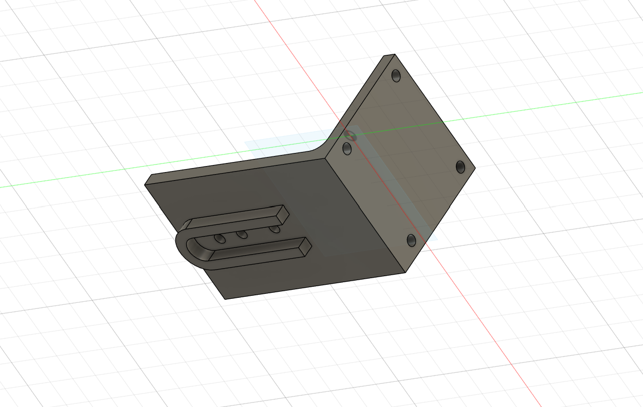
[picture p40: Reports/Anas/Images/Capture d'écran 2024-02-22 140217.png]

J'ai opté pour une impression 3D pour cette pièce. Elle sera vissée à l'arrière de la coque du robot, puis les moteurs seront fixés à cette pièce. Ensuite, tous les câbles seront collés à la pièce et passeront au tube via les petits trous de la base inférieure. Nous devrons donc rendre ces trous étanches par la suite.

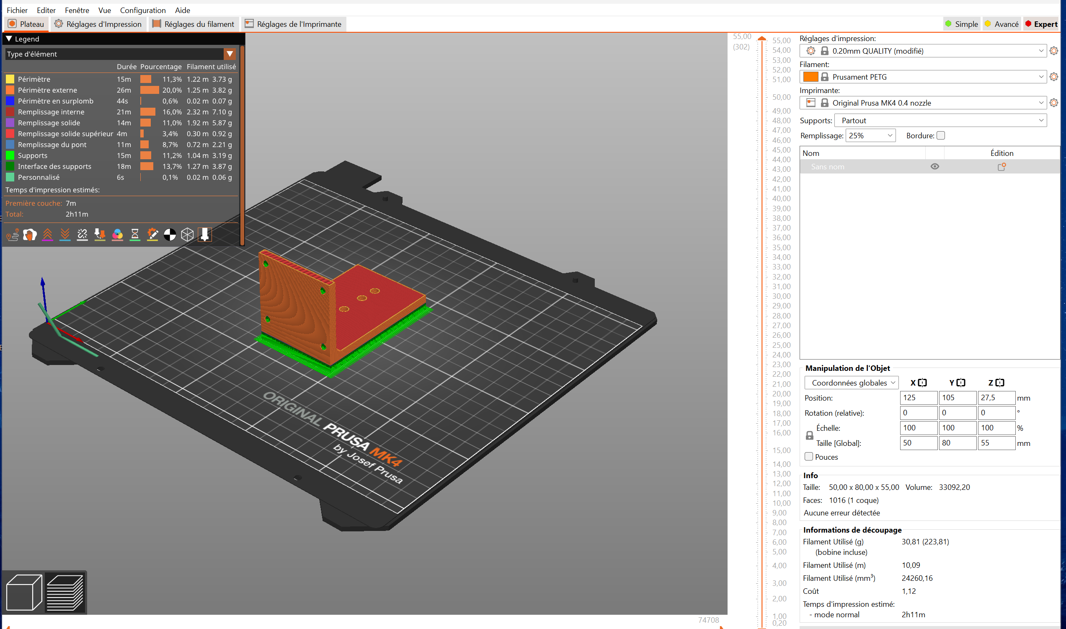
[picture p41: Reports/Anas/Images/Capture d'écran 2024-02-22 140135.png]


Ensuite, pour les paramètres d'impression, j'ai opté pour un remplissage de 25%. Comme c'est la pièce qui va relier nos moteurs à notre coque, elle se doit d'être suffisamment rigide pour supporter toutes les contraintes, tout en restant assez flexible et légère.

Objectifs pour la séance prochaine : 
-	assembler le robot.
