TibaudoRomain/ProjetAR/Reports/Anas/séance 9.md

# **Séance 9**
## *13-2-2024* 

## Travail réalisé :
Pour cette séance, j'ai commencé par couper les plaques de bois qui serviront à fixer les moteurs sur la base en bois. J'ai donc décidé de les couper à la découpeuse laser.
J'ai rencontré un problème qui faisait que ma découpe était déformée par rapport à ce que j'avais dessiné.
Après avoir réglé ce problème, j'ai découpé toutes les pièces de bois nécessaires.
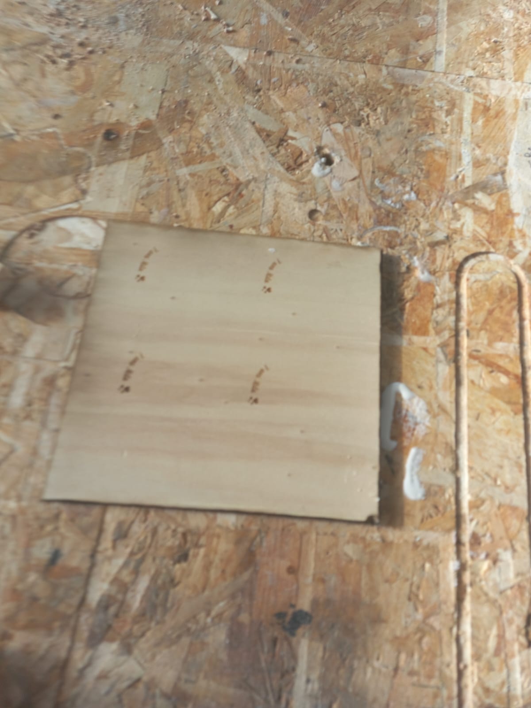
[picture p42: Reports/Anas/Images/WhatsApp Image 2024-02-14 at 09.22.11.jpeg]

Je les ai collées avec de la colle à bois à la structure que j'avais commencée lors de la séance précédente. En attendant que la colle sèche, j'ai effectué quelques découpes de bois. Une fois la colle séchée, j'ai remarqué que cela n'avait pas très bien tenu, j'ai donc ajouté de la colle.

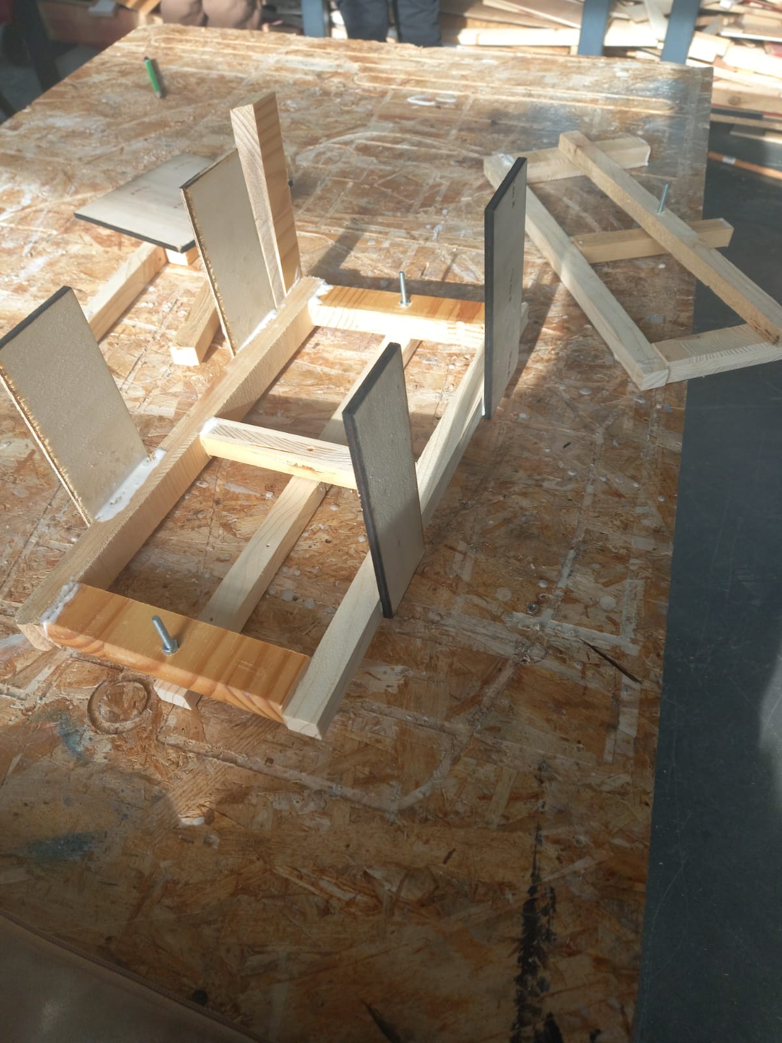
[picture p43: Reports/Anas/Images/WhatsApp Image 2024-02-14 at 09.22.11 (2).jpeg]


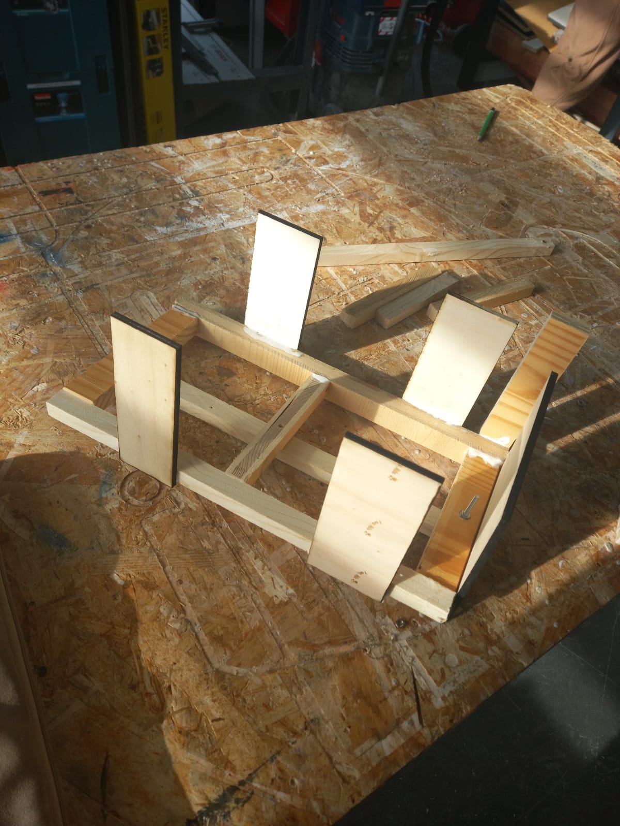
[picture p44: Reports/Anas/Images/WhatsApp Image 2024-02-14 at 09.22.11 (1).jpeg]


Finalement, ça a bien tenu. J'ai donc cette fois-ci découpé les compartiments de notre tube afin de pouvoir y fixer toute notre électronique.
Objectifs pour la séance prochaine : 
-	En attendant que la commande de mesh arrive, j'ai fini de fixer toutes les pièces de bois.
