TibaudoRomain/ProjetAR/Reports/Romain/Report08.md

# **Séance 8 - 07/02/2024**
## Travail réalisé :
J'ai commencé par essayer d'installer VScode un logiciel qui me permettra de lancer des programmes python et de pouvoir utiliser les données des capteurs.
Cependant lorsque j'ai essayer d'installer le logiciel un message d'erreur m'indiquant que mon installation est instable a bloqué mon installation.
Après une courte recherche, j'ai trouvé qu'il me fallait changer d'image.
Le problème est que l'image pèse 10GB et que l'internet est lent.



De plus je ne pouvais pas mettre l'image telle qu'elle dans la clé USB et j'ai du la compresser. J'ai donc ensuite reformater la carte SD pour ensuite réinstaller l'image.



Cependant compresser l'image était une erreur car après l'avoir flashée et lancé sur la jetson nano, je me suis rendu compte que compresser l'image la rend inutilisable, j'ai donc du me remettre à télécharger l'image. Puis n'ayant pas le temps de finir l'installation j'ai décidé de récupérer le matèriel pour pouvoir la faire chez moi et j'attends maintenant la fin du téléchargement.

## Objectifs pour les prochaines scéances :
D'ici la prochaine scéance j'aurais fini l'installation, les objectifs seront donc les mêmes qu'à la scéance précédente :
- S'assurer que la communication a bien été établie
- Ecrire et tester le programme pour stabiliser le robot
