TibaudoRomain/ProjetAR/Reports/Anas/séance 8.md

# **Séance 8**
## *07-2-2024* 

## Travail réalisé :

Lors de cette séance, j'ai commencé par découper les poutres en bois nécessaires à la structure. Une fois ces poutres découpées, il a fallu les agencer afin de choisir celles qui serviront pour la structure du bas et celle du haut. 

Ensuite, je suis passé à l'assemblage des poutres en bois afin de former la base inférieure et supérieure de la structure. J'ai utilisé de la colle à bois pour que les poutres tiennent en place.


Une fois la colle sèche, je suis passé au perçage de trous dans les poutres afin de les visser ensemble et d'éviter tout risque d'effondrement de la structure en bois.


Objectif de la séance prochaine : 
-	remettre une couche de colle , et revetire la strucutre de mesh.
