TibaudoRomain/ProjetAR/Reports/Anas/séance 7.md

# **Séance 7**
## *23-01-2024* 

## Travail réalisé :
Lors de la séance de robotique, j'ai dû procéder à un changement de modèle de robot en raison de notre retard sur le planning, En effet, en optant pour une coque en impression 3D, cela prendrait plus de temps qu'initialement prévu. Ainsi, pour se démarquer, nous avons décidé de changer le modèle du robot.
En conséquence, j'ai entrepris de remodeliser la coque extérieure pour s'adapter au nouveau modèle. Le nouveau design a été élaboré en prenant en compte le temps a respecter, ainsi qu'un disign un peu different des autre projet.
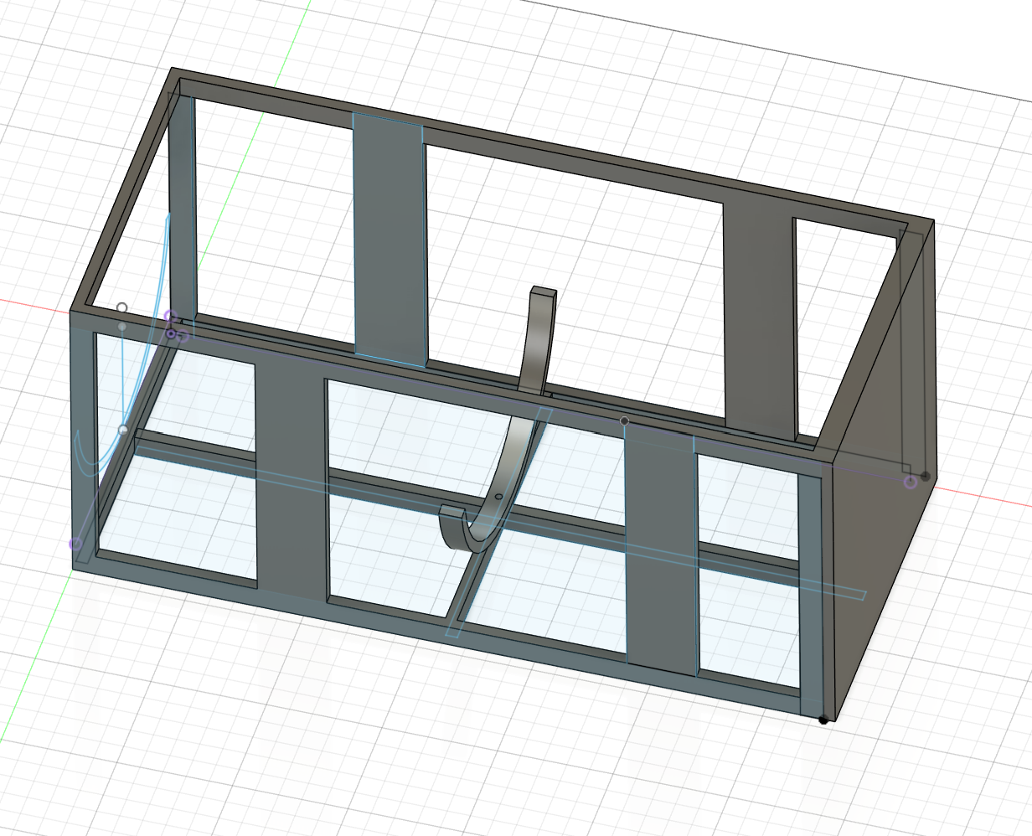
[picture p47: Reports/Anas/Images/coque V4.png]

La structure sera ensuite revêtue de mesh qui sera à la fois flexible et robuste.



Suite à cela, j'ai passé commande pour les matériaux nécessaires à la construction du robot. Une fois la livraison arrivé, nous allons monter le robot afin de faire des tests dans l eau.

Objectif de la séance prochaine : 
-	contruire la structure en bois.
