TibaudoRomain/ProjetAR/Reports/Romain/Report05.md

# **Séance 5 - 08/01/2024**
## Travail réalisé :
Dans un premier temps, j'ai recherché comment faire fonctionner la centrale inertielle. Après avoir essayé sans succés de faire fonctionner le programme exemple nommé MPU6050_dmp6, j'ai décidé d'utiliser d'autres librairies et d'utiliser un programme plus simple nommé "CentraleInertielleW" trouvable dans ProjetAR/Reports/Romain/Code.

J'ai tout d'abord changé le branchement de la centrale inertielle comme ceci : 



(Screenshot de https://www.youtube.com/watch?v=oqmbVeRlLgg&t=330s)


Cependant, avant de faire marcher le code j'ai du résoudre plusieurs problème. Le premier était que l'IDE n'arrivait pas à upload le code sur la carte arduino, après avoir réinstallé le driver ch340 et redémarré mon pc plusieurs fois, le problème s'est résolu. Un autre problème que j'ai rencontré est un problème avec certaines libraries, en effet le programme exemple de l'IDE a besoin d'une library appelée Toxiclibs que je n'ai pas pu trouvé. C'est aussi pour cela que j'ai utilisé un autre programme.

Ces problèmes résolus, un autre est survenu, la centrale inertielle n'arrive pas à calibrer son accélération.



Cependant en posant la centrale inertielle à plat comme sur cette image :



La centrale inertielle arrive à calibrer son accélération et j'obtiens ces résultats : 
