TibaudoRomain/ProjetAR/Reports/Anas/séance 4.md

# **Séance 3**
## *08-12-2023* 

## Travail réalisé :

Aujourd’hui, j'ai commencé la séance en discutant avec Xavier à propos d'une façon de rendre nos soudures étanches afin de sécuriser nos fils électriques qui vont du tube aux composants extérieurs (moteurs, capteurs, etc.). Elle consiste à injecter de la colle à l'aide d'un pistolet à colle dans un moule qui contient les fils. Une fois la colle refroidie, le fil devient étanche.
Ensuite, j'ai lancé l'impression de la pièce de la séance précédente.


J'ai ensuite modélisé la première partie de notre coque extérieure, qui est un bras reliant la fixation du tube. Cette pièce sera fixée avec la pièce de fixation à l'aide d'une vis.
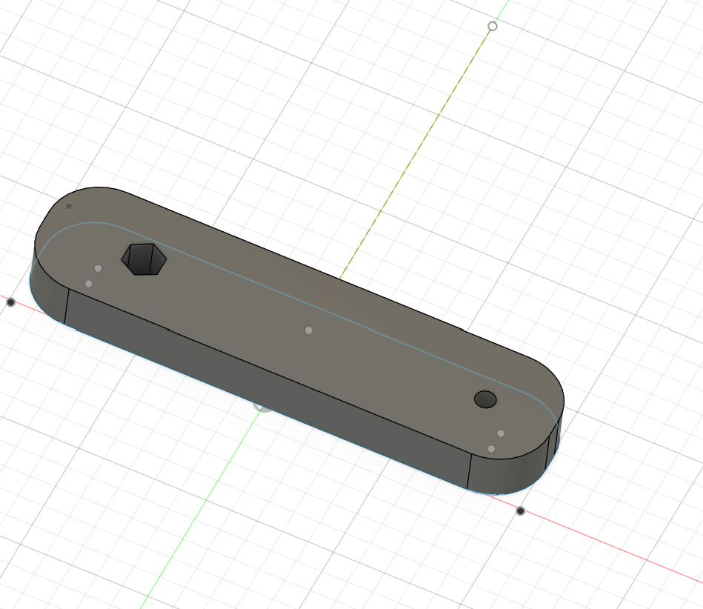
[picture p48: Reports/Anas/Images/modélisation du bras.png]


Puis, elle sera fixée au reste de la coque à l'aide d'un écrou piège à l'intérieur du bras. Elle sera ainsi vissée au reste.

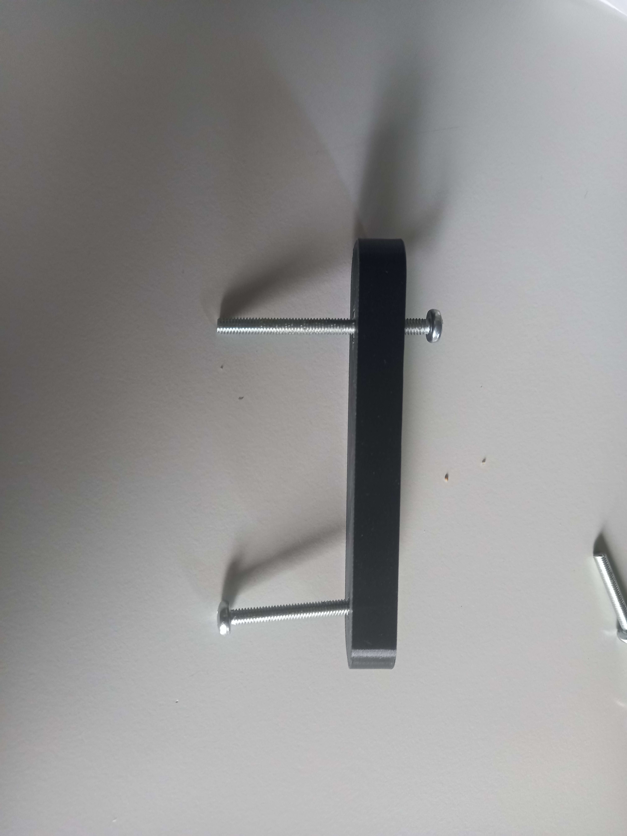
[picture p49: Reports/Anas/Images/bras avec vis.jpg]


Pour l'instant, j'ai imprimé trois de ces bras et j'ai fixé les écrous à l'intérieur



J'ai donc récupéré les vis dont j'ai besoin, pris les mesures et coupé les vis à la taille voulue. Ensuite, j'ai vissé toutes les vis dans les trous des bras imprimés afin de les tarauder.

Objectifs pour la séance prochaine : 
-       avancer sur le modele de la coque exterieur
