TibaudoRomain/ProjetAR/Reports/Anas/séance 3.md

# **Séance 3**
## *08-12-2023* 
## Travail réalisé :

Pour la séance d'aujourd'hui, je me suis penché sur la modélisation de la solution de fixation de notre tube de plexiglas à notre coque extérieure.

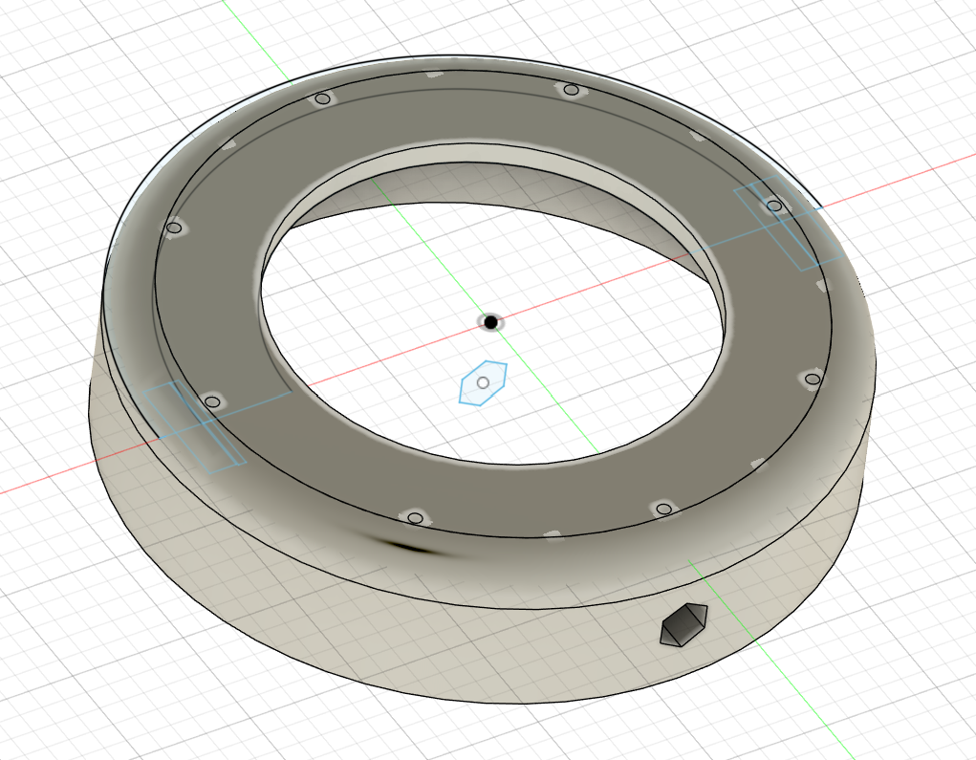
[picture p51: Reports/Anas/Images/modelisation1.png]


Je me suis ensuite penché sur la problématique de relier notre pièce à la coque. J'ai opté pour des vis qui relieront la coque à notre pièce. J'ai donc identifié le de vis qu'il nous faudra, puis j'ai coupé les vis à la taille idéale et enfin, j'ai limé les extrémités des vis.

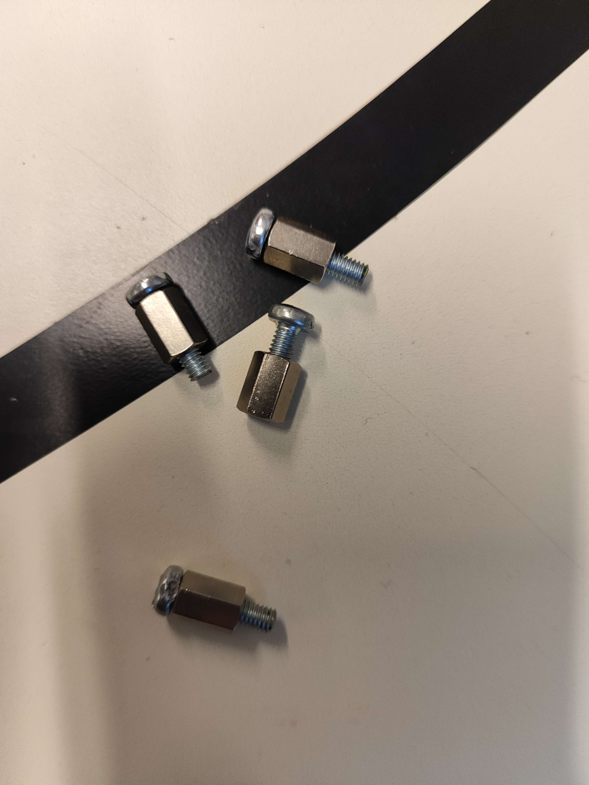
[picture p52: Reports/Anas/Images/solution de fixation.jpg]


J'ai ensuite modifié ma modélisation pour pouvoir y fixer ces vis, puis j'ai lancé l'impression 3D.

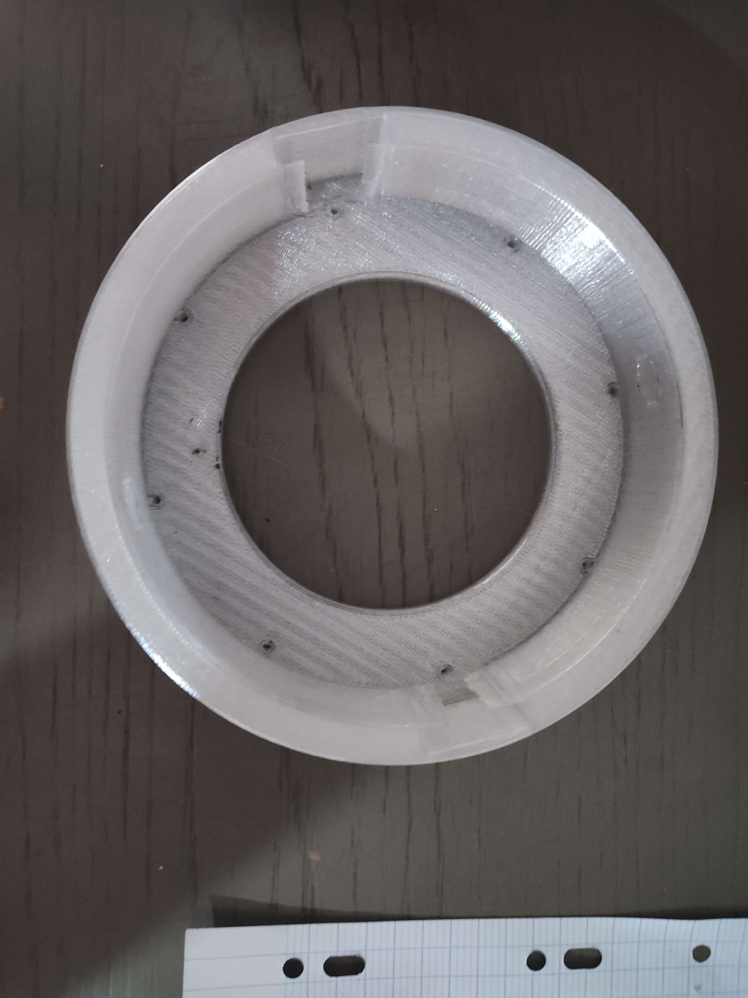
[picture p53: Reports/Anas/Images/impression1.jpg]


Après l'avoir récupérée, j'avais remarqué que les trous sur le côté étaient trop grands. Bien sûr, j'ai refait les mesures, il ne reste plus qu'à l'imprimer.

Objectifs pour la séance prochaine : 
-       recevoir le tube et fixer nos 2 pieces dessus
-       avancer sur le modele de la coque exterieur
