TibaudoRomain/ProjetAR/Reports/Anas/séance 1.md

# **Séance 1**
## *14-11-2023* 
## Travail réalisé : 
 
Pour cette première séance, on a reçue les premiers composants de notre Projet : 
-	Moteur brushless 
-	Esc 

Personnellement, je me suis concentré sur la coque de notre robot, plus spécifiquement, sur l’étanchéité de la boîte qui servira à abriter les composants électroniques de notre robot. 
Xavier nous a conseillé de lire un blog traitant l’impression3D de modèle creux et étanche.



Créer une boîte étanche représente un défi de taille, avec tous les branchements qu’on devra faire passer, le fait qu'elle doit pouvoir s’ouvrir, la tâche n'est pas des plus aisés.
Il faut tout d’abord prendre en compte la force de pression qui sera exercé sur notre boîte, afin de terminer l’épaisseur des couches d’impression requit. 


Ensuite il faut déterminer le nombre et la taille de troue que notre boite doit avoir afin de les rendre étanche à leur tour, ensuite on doit garantir l’étanchéité resettera la même après une ouverture de la boite.

Objectifs pour la séance prochaine : 
-	Imprimer la boîte afin de la tester méticuleusement avant de mettre des circuits électriques à l’intérieur.
-	Commencer la modélisation de la coque extérieure et l’imprimer
