TibaudoRomain/ProjetAR/Reports/Anas/Images/WhatsApp Image 2024-03-07 at 19.45.26.jpeg

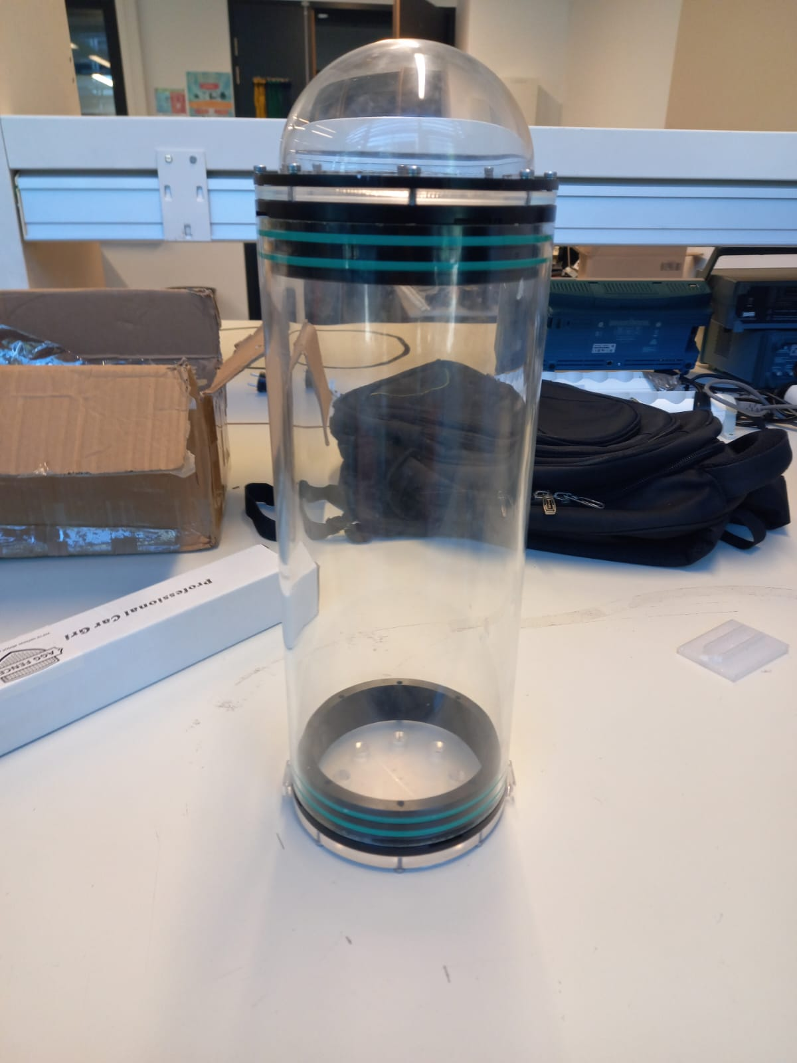
Reports/Anas/Images/WhatsApp Image 2024-03-07 at 19.45.26.jpeg
