TibaudoRomain/ProjetAR/Reports/Romain/Images/SchémaGestionStabilité.png

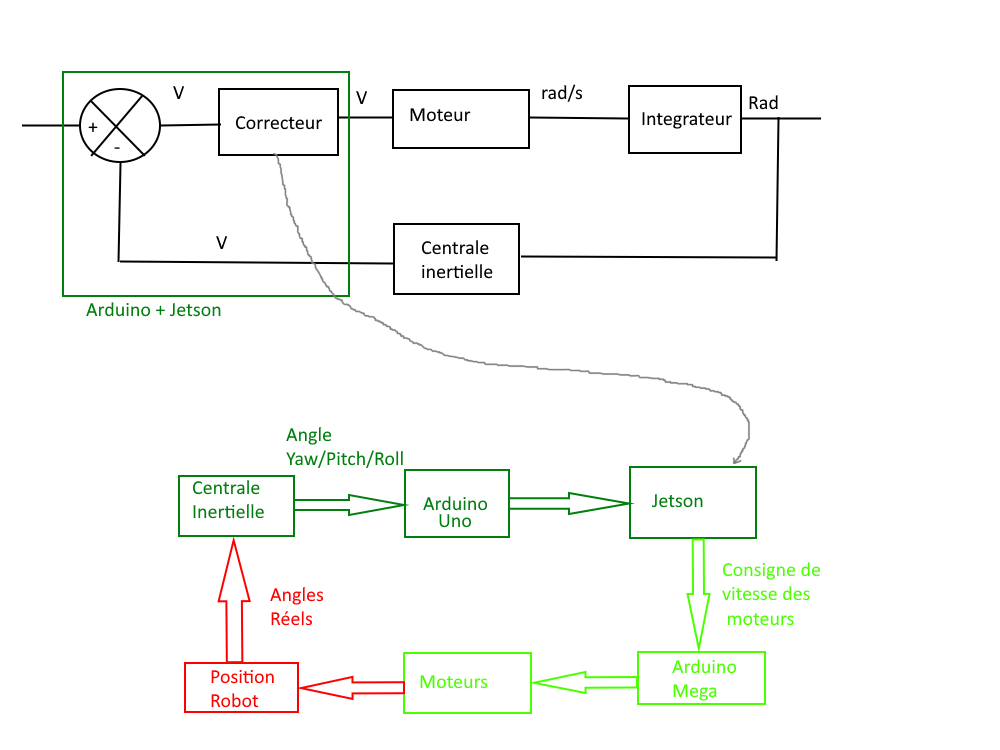
Reports/Romain/Images/SchémaGestionStabilité.png
