TibaudoRomain/ProjetAR/Reports/Anas/Images/modélisation du bras .3mf

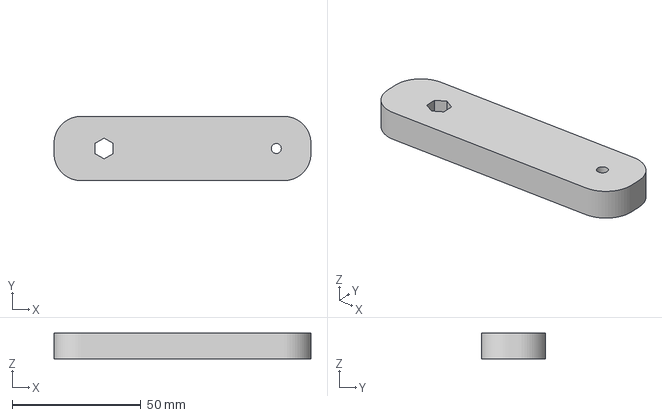
[picture p56: CAD file, 2023-12-13, last stored version]
Reports/Anas/Images/modélisation du bras .3mf
100.0 x 25.0 x 10.0 mm
