TibaudoRomain/ProjetAR/Reports/Romain/Code/CentraleInertielleW.ino

/* ============================================
  Simple_MPU6050 device library code is placed under the MIT license
  Copyright (c) 2021 Homer Creutz

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
  THE SOFTWARE IS PROVIDED "AS IS", WITHOUT WARRANTY OF ANY KIND, EXPRESS OR
  IMPLIED, INCLUDING BUT NOT LIMITED TO THE WARRANTIES OF MERCHANTABILITY,
  FITNESS FOR A PARTICULAR PURPOSE AND NONINFRINGEMENT. IN NO EVENT SHALL THE
  AUTHORS OR COPYRIGHT HOLDERS BE LIABLE FOR ANY CLAIM, DAMAGES, OR OTHER
  LIABILITY, WHETHER IN AN ACTION OF CONTRACT, TORT, OR OTHERWISE, ARISING FROM,
  OUT OF OR IN CONNECTION WITH THE SOFTWARE OR THE USE OR OTHER DEALINGS IN
  THE SOFTWARE.
  ===============================================
*/

/*
 *  Use with any MPU: MPU6050, MPU6500, MPU9150, MPU9155, MPU9250 
 *  Attach the MPU to the I2C bus
 *  Power MPU According to specs of the breakout board. Generic Breakout Version Powers with 5V and has an onboard Voltage regulator.
 *  run the Sketch
 */

#include "Simple_MPU6050.h"
#define MPU6050_DEFAULT_ADDRESS     0x68 // address pin low (GND), default for InvenSense evaluation board

Simple_MPU6050 mpu;

//***************************************************************************************
//******************              Callback Funciton                **********************
//***************************************************************************************

// See mpu.on_FIFO(print_Values); in the Setup Loop
void Print_Values (int16_t *gyro, int16_t *accel, int32_t *quat) {
  Quaternion q;
  VectorFloat gravity;
  float ypr[3] = { 0, 0, 0 };
  float xyz[3] = { 0, 0, 0 };
  mpu.GetQuaternion(&q, quat);
  mpu.GetGravity(&gravity, &q);
  mpu.GetYawPitchRoll(ypr, &q, &gravity);
  mpu.ConvertToDegrees(ypr, xyz);
  
  Serial.print(F("Yaw "));   Serial.print(xyz[0]);   Serial.print(F(",   "));
  Serial.print(F("Pitch ")); Serial.print(xyz[1]);   Serial.print(F(",   "));
  Serial.print(F("Roll "));  Serial.print(xyz[2]);   Serial.print(F(",   "));
  Serial.print(F("ax "));    Serial.print(accel[0]); Serial.print(F(",   "));
  Serial.print(F("ay "));    Serial.print(accel[1]); Serial.print(F(",   "));
  Serial.print(F("az "));    Serial.print(accel[2]); Serial.print(F(",   "));
  Serial.print(F("gx "));    Serial.print(gyro[0]);  Serial.print(F(",   "));
  Serial.print(F("gy "));    Serial.print(gyro[1]);  Serial.print(F(",   "));
  Serial.print(F("gz "));    Serial.print(gyro[2]);  Serial.print(F("\n"));
  Serial.println();
}

//***************************************************************************************
//******************                Setup and Loop                 **********************
//***************************************************************************************

void setup() {
  // initialize serial communication
  Serial.begin(115200);
  while (!Serial); // wait for Leonardo enumeration, others continue immediately
  Serial.println(F("Start:"));

  // Setup the MPU and TwoWire aka Wire library all at once
  mpu.begin();
  mpu.Set_DMP_Output_Rate_Hz(10);          // Set the DMP output rate from 200Hz to 5 Minutes.
  //mpu.Set_DMP_Output_Rate_Seconds(10);   // Set the DMP output rate in Seconds
  //mpu.Set_DMP_Output_Rate_Minutes(5);    // Set the DMP output rate in Minute
 mpu.CalibrateMPU();                      // Calibrates the MPU.
  mpu.load_DMP_Image();                    // Loads the DMP image into the MPU and finish configuration.
  mpu.on_FIFO(Print_Values);               // Set callback function that is triggered when FIFO Data is retrieved
  // Setup is complete!
  
}

void loop() {
  static unsigned long FIFO_DelayTimer;
  if ((millis() - FIFO_DelayTimer) >= (99)) { // 99ms instead of 100ms to start polling the MPU 1ms prior to data arriving.
    if( mpu.dmp_read_fifo(false)) FIFO_DelayTimer= millis() ; // false = no interrupt pin attachment required and When data arrives in the FIFO Buffer reset the timer
  }
  // dmp_read_fifo(false) does the following
  // Tests for Data in the FIFO Buffer
  // when it finds data it runs the mpu.on_FIFO(print_Values)
  // the print_Values function which we set run the PrintAllValues Function
  // When data is captured dmp_read_fifo will return true.
  // The print_Values function MUST have the following variables available to attach data
  // void print_Values (int16_t *gyro, int16_t *accel, int32_t *quat, uint32_t *timestamp)
  // Variables:
  // int16_t *gyro for the gyro values to be passed to it (The * tells the function it will be a pointer to the value)
  // int16_t *accel for the accel values to be passed to it
  // int32_t *quat for the quaternion values to be passed to it
  // uint32_t *timestamp which will be the micros()value at the time we retrieved the Newest value from the FIFO Buffer.
}
