TibaudoRomain/ProjetAR/(commit log)

2023-12-09 Rename 1702133534521.jpg to solution de fixation.jpg
2023-12-13 Rename 20231213_133451.jpg to solution de fixation 01.jpg
2023-12-13 Rename Sans nom.3mf to modélisation du bras .3mf
    [modélisation du bras .3mf]
2024-01-17 Rename image.png to attache tube.png
