TibaudoRomain/ProjetAR/Reports/Anas/Images/20240207_165456.jpg

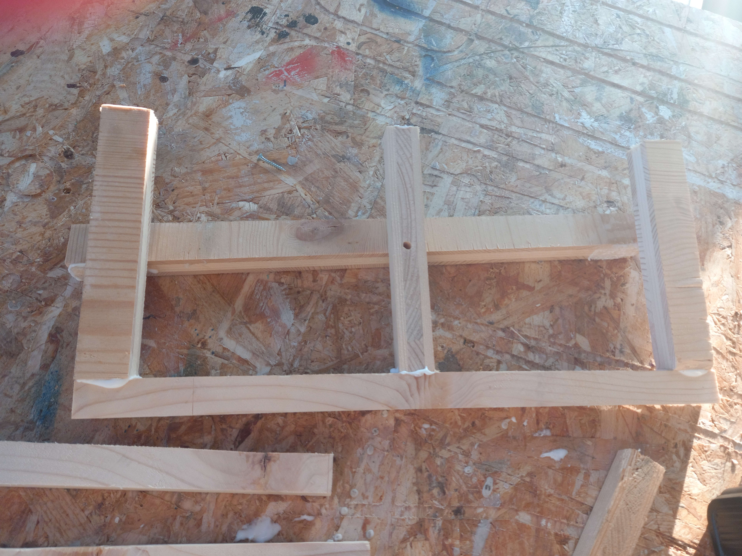
[picture p45: Reports/Anas/Images/20240207_165456.jpg]
Reports/Anas/Images/20240207_165456.jpg
