TibaudoRomain/ProjetAR/Reports/Anas/Images/20240207_165450.jpg

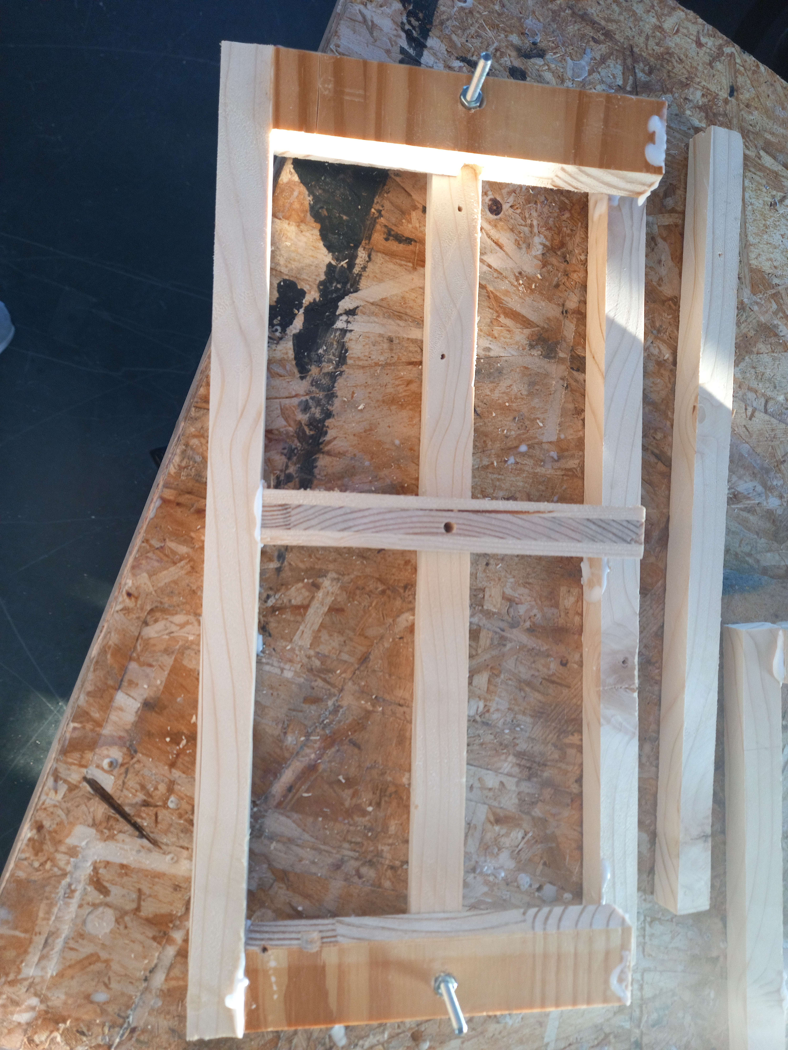
[picture p46: Reports/Anas/Images/20240207_165450.jpg]
Reports/Anas/Images/20240207_165450.jpg
