TibaudoRomain/ProjetAR/Reports/Anas/Images/20231213_133521.jpg

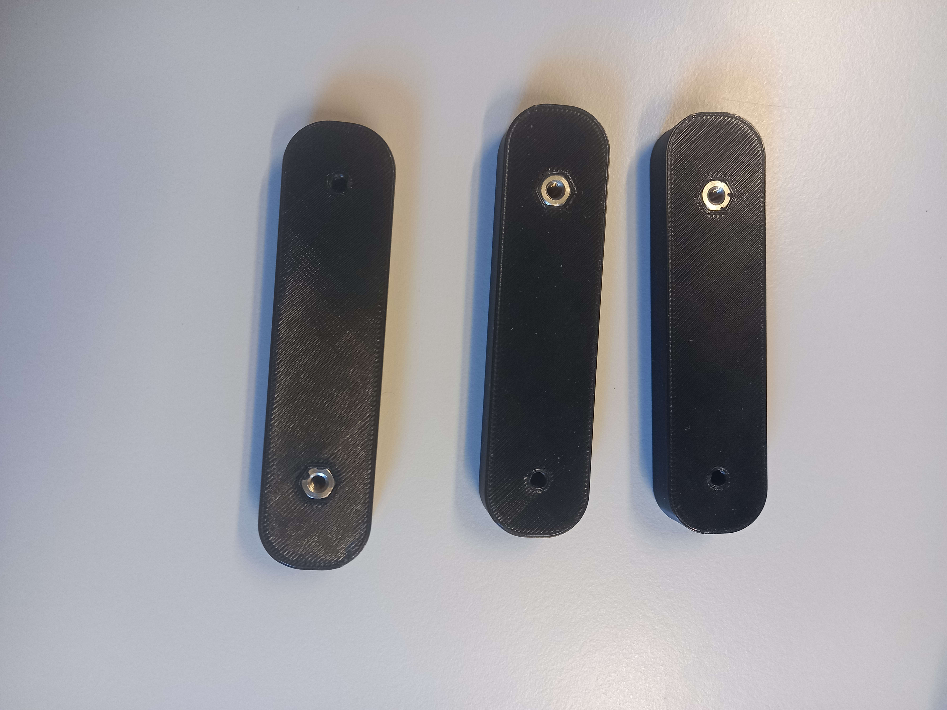
[picture p50: Reports/Anas/Images/bras imprimé avec ecrou.jpg]
Reports/Anas/Images/20231213_133521.jpg
